Roboy/kicad_db/_3Dmodels/README.md

## this folder must be maintained empty on github
### the DIR structure is useful to test and generate models locally.
