Roboy/kicad_db/_3Dmodels/4UCON_17809/4UCON_17809_02x10x1.27mm_Vertical.step

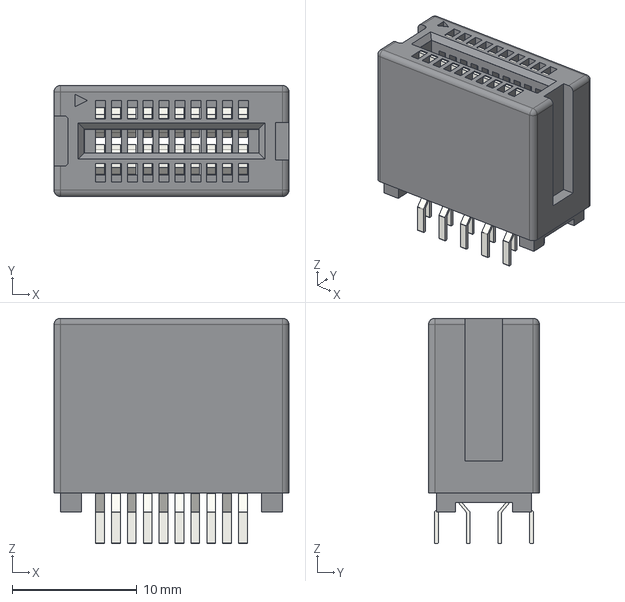
[picture p1: CAD file, 2017-06-21]
_3Dmodels/4UCON_17809/4UCON_17809_02x10x1.27mm_Vertical.step
18.8 x 8.88 x 18.0 mm
