Roboy/kicad_db/_3Dmodels/BGA_packages/Texas_Junior_DSBGA-12_4x3_2.5x2.0mm_Pitch0.5mm_Dia0.30mm.step

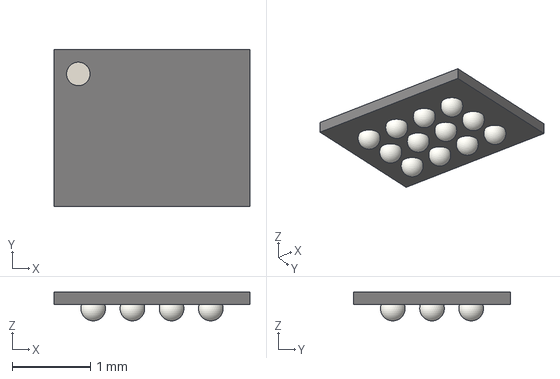
[picture p2: CAD file, 2017-06-21]
_3Dmodels/BGA_packages/Texas_Junior_DSBGA-12_4x3_2.5x2.0mm_Pitch0.5mm_Dia0.30mm.step
2.50 x 2.00 x 0.367 mm
