Roboy/kicad_db/_3Dmodels/Capacitors_Radial_SMD/CP_Elec_5x4.5.step

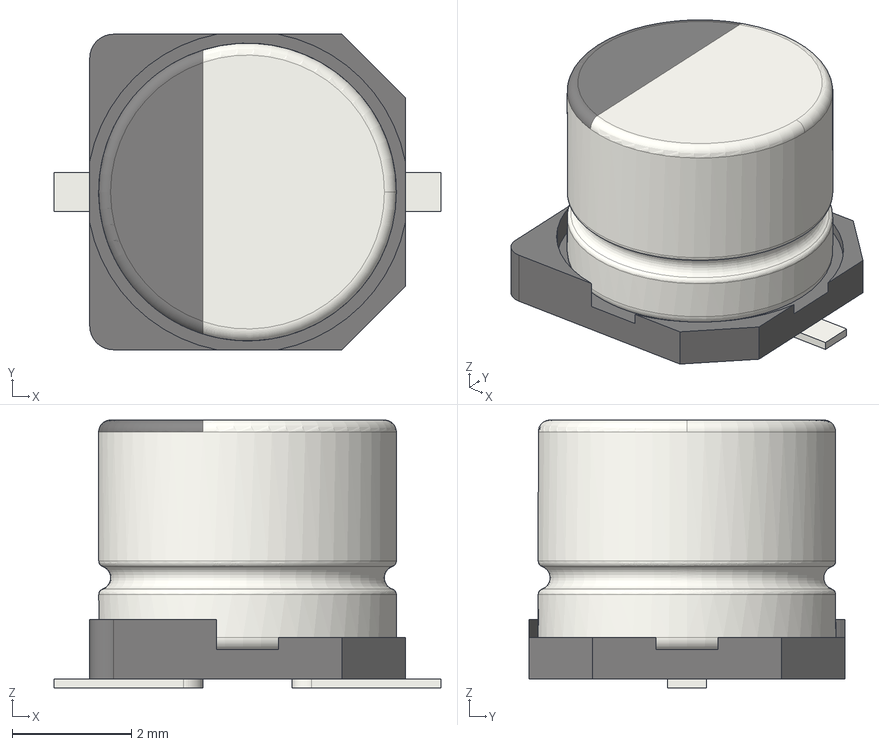
[picture p4: CAD file, 2017-06-21]
_3Dmodels/Capacitors_Radial_SMD/CP_Elec_5x4.5.step
6.50 x 5.30 x 4.50 mm
