Roboy/kicad_db/_3Dmodels/Capacitors_Radial_THT/CP_Radial_D10.0mm_P7.50mm.step

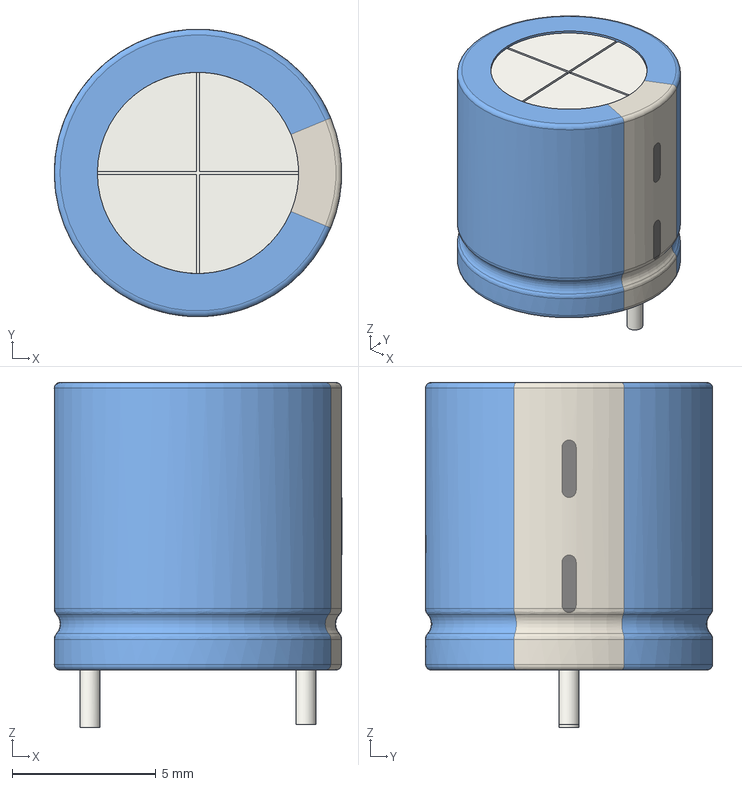
[picture p5: CAD file, 2017-06-21]
_3Dmodels/Capacitors_Radial_THT/CP_Radial_D10.0mm_P7.50mm.step
10.00 x 9.99 x 12.0 mm
