Roboy/kicad_db/_3Dmodels/Capacitors_Rect_THT/C_Rect_L4.6mm_W5.5mm_P2.50mm_MKS02_FKP02.step

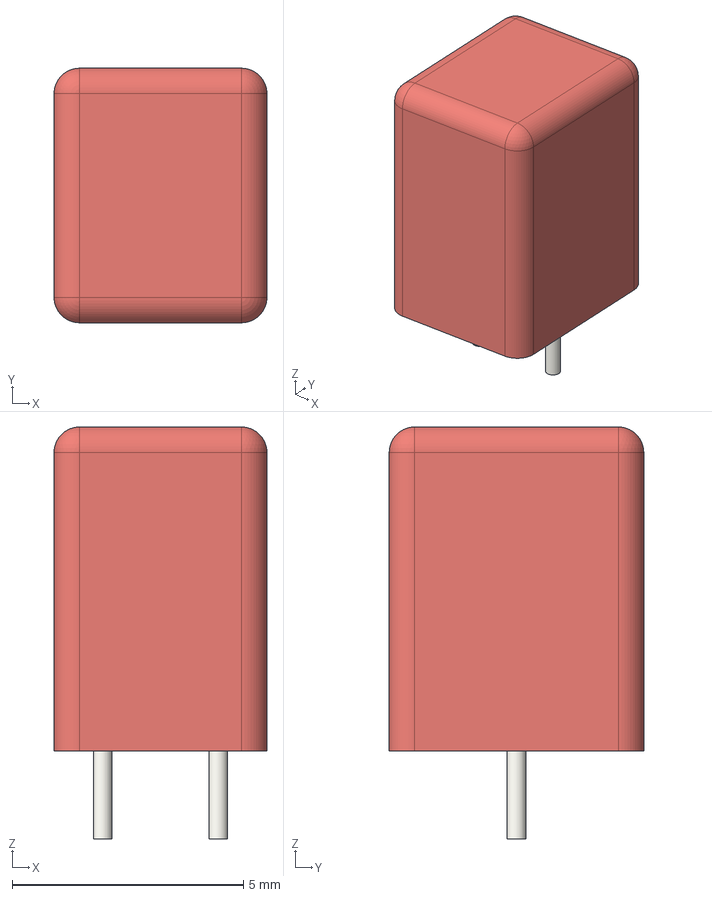
[picture p6: CAD file, 2017-06-21]
_3Dmodels/Capacitors_Rect_THT/C_Rect_L4.6mm_W5.5mm_P2.50mm_MKS02_FKP02.step
4.60 x 5.50 x 8.90 mm
