Roboy/kicad_db/_3Dmodels/custom_lib.3d_shapes/LED_WS2812B-PLCC4_3.5x3.5.step

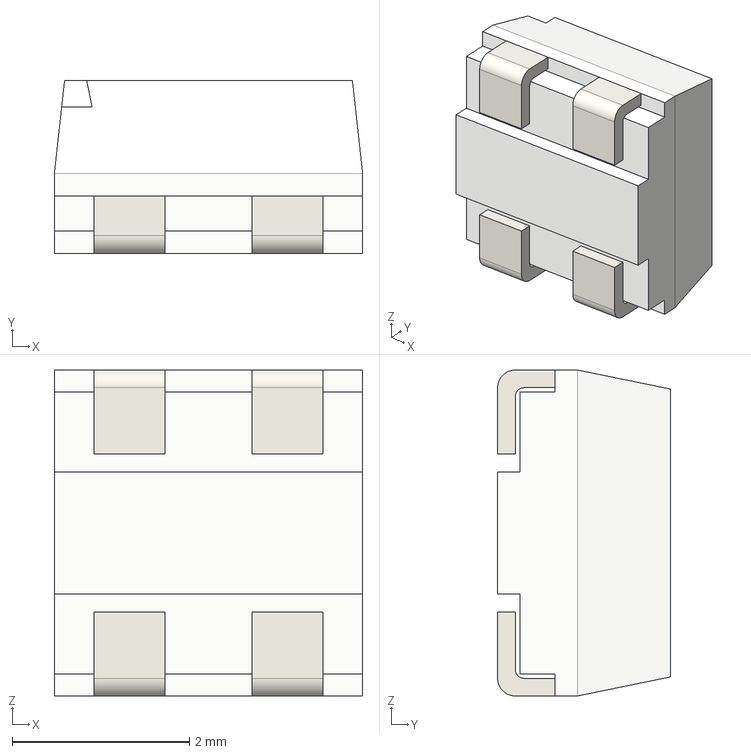
[picture p7: CAD file, 2019-05-12]
_3Dmodels/custom_lib.3d_shapes/LED_WS2812B-PLCC4_3.5x3.5.step
3.48 x 1.95 x 3.68 mm
