Roboy/kicad_db/_3Dmodels/Diodes_SMD/D_SMA.step

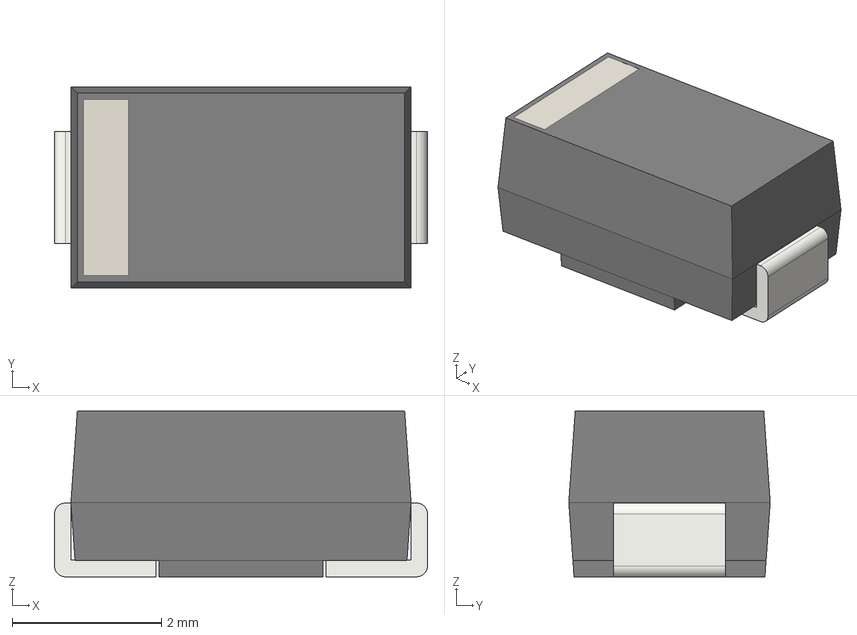
[picture p8: CAD file, 2017-06-21]
_3Dmodels/Diodes_SMD/D_SMA.step
5.00 x 2.70 x 2.22 mm
