Roboy/kicad_db/_3Dmodels/DIP_packages/DIP-48_W15.24mm.step

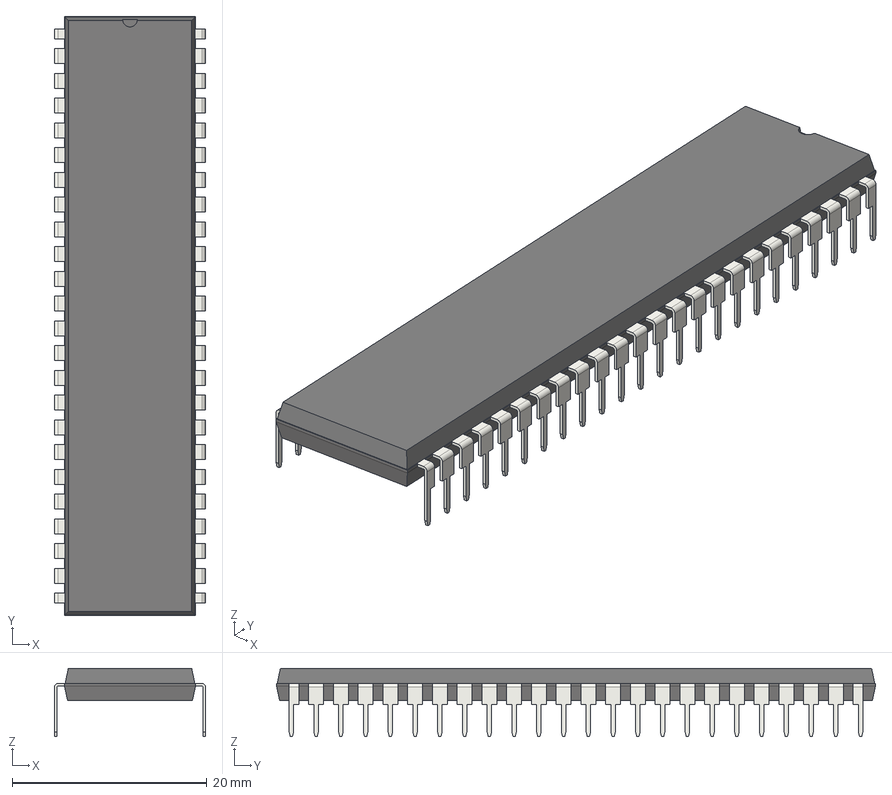
[picture p9: CAD file, 2017-06-21]
_3Dmodels/DIP_packages/DIP-48_W15.24mm.step
15.5 x 61.5 x 6.98 mm
