Roboy/kicad_db/_3Dmodels/TLE493d.step

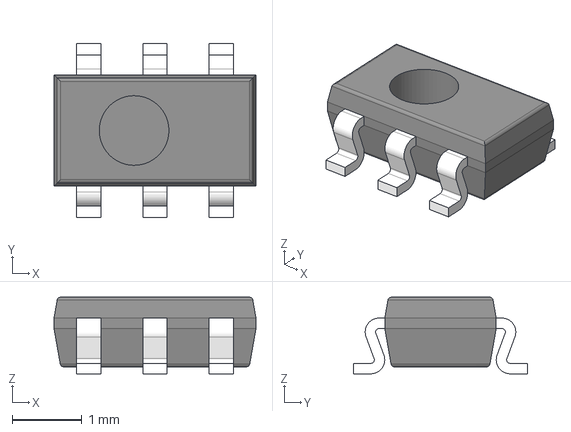
[picture p12: CAD file, 2020-06-25]
_3Dmodels/TLE493d.step
2.90 x 2.50 x 1.10 mm
