Roboy/kicad_db/_3Dmodels/4UCON_17809/4UCON_17809_02x40x1.27mm_Vertical.FCStd

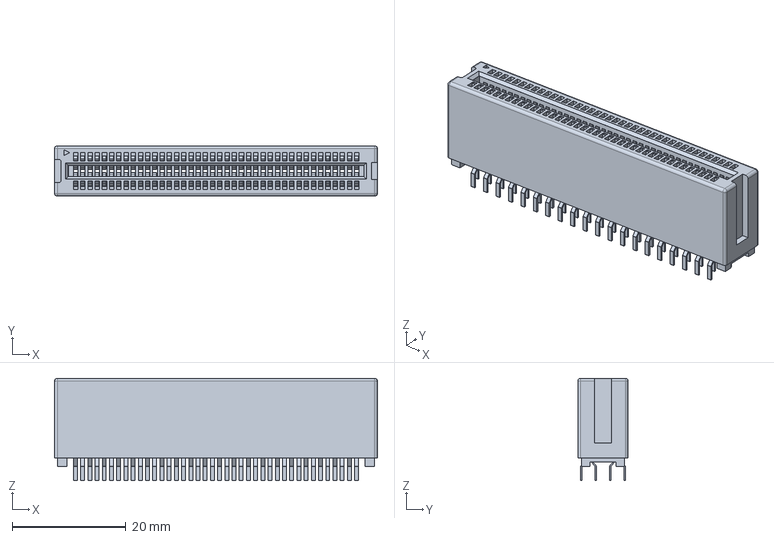
[picture p13: CAD file, 2017-06-21]
_3Dmodels/4UCON_17809/4UCON_17809_02x40x1.27mm_Vertical.FCStd
56.9 x 8.88 x 18.0 mm
