Roboy/kicad_db/_3Dmodels/BGA_packages/BGA-144_12x12_13.0x13.0mm_Pitch1.0mm.step

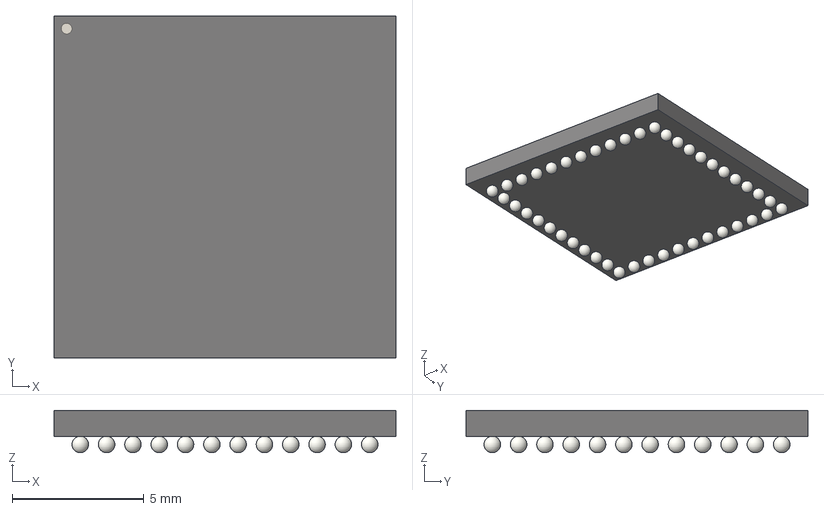
[picture p14: CAD file, 2017-06-21]
_3Dmodels/BGA_packages/BGA-144_12x12_13.0x13.0mm_Pitch1.0mm.step
13.0 x 13.0 x 1.61 mm
