Roboy/kicad_db/_3Dmodels/Box_Headers/Box_Header_Straight_2x20x2.54mm.step

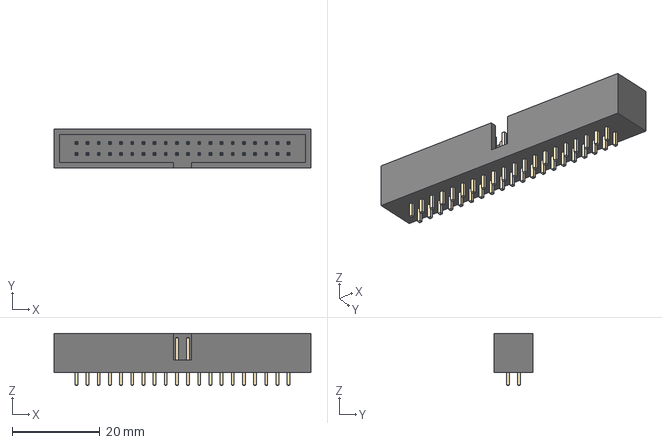
[picture p15: CAD file, 2017-06-21]
_3Dmodels/Box_Headers/Box_Header_Straight_2x20x2.54mm.step
58.4 x 8.90 x 11.9 mm
