Roboy/kicad_db/_3Dmodels/Capacitors_Radial_SMD/CP_Elec_8x6.5.step

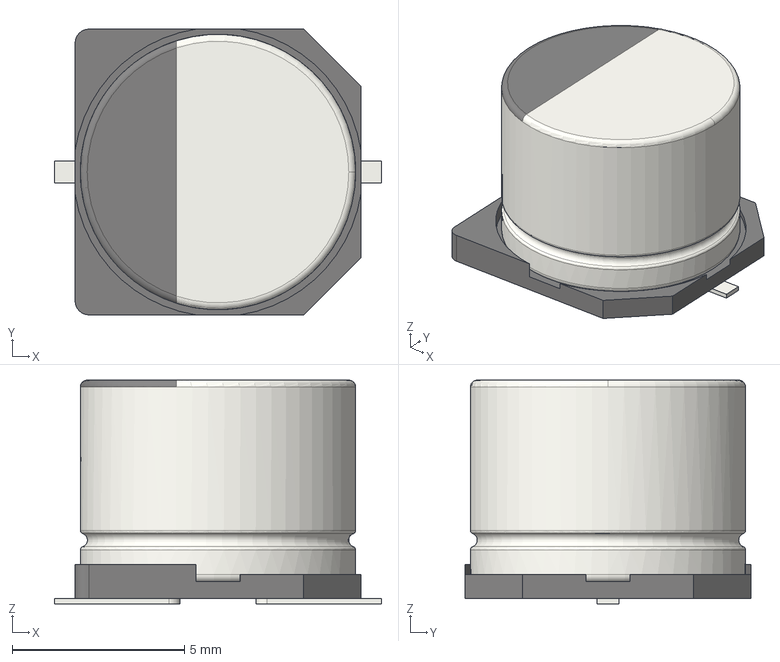
[picture p16: CAD file, 2017-06-21]
_3Dmodels/Capacitors_Radial_SMD/CP_Elec_8x6.5.step
9.50 x 8.30 x 6.50 mm
