Roboy/kicad_db/_3Dmodels/Capacitors_Radial_THT/CP_Radial_D8.0mm_P5.00mm.step

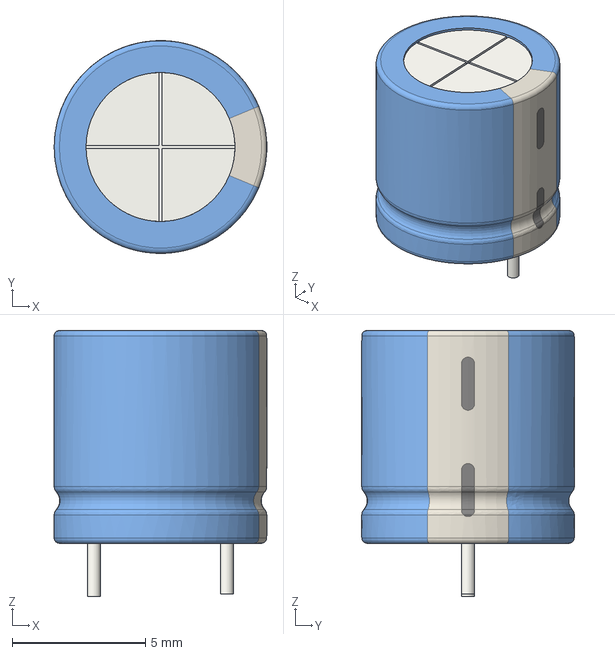
[picture p17: CAD file, 2017-06-21]
_3Dmodels/Capacitors_Radial_THT/CP_Radial_D8.0mm_P5.00mm.step
8.00 x 8.00 x 10.0 mm
