Roboy/kicad_db/_3Dmodels/Capacitors_Rect_THT/C_Rect_L16.5mm_W4.9mm_P15.00mm_MKT.step

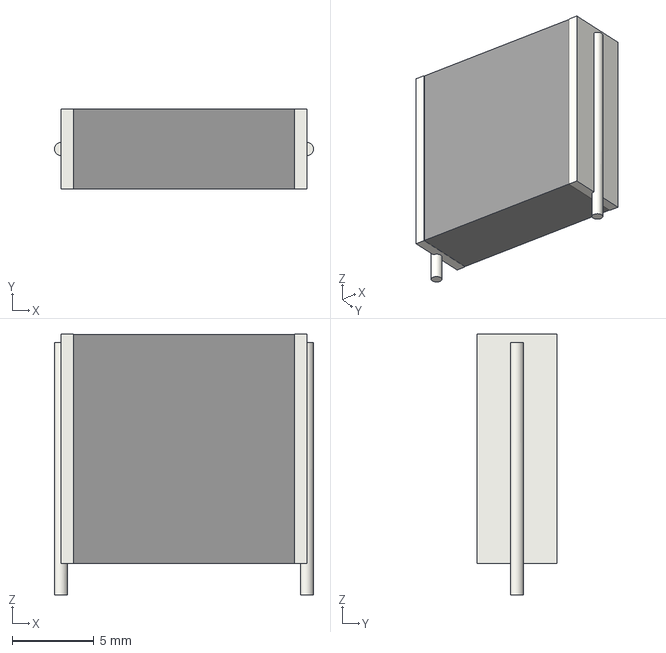
[picture p18: CAD file, 2017-06-21]
_3Dmodels/Capacitors_Rect_THT/C_Rect_L16.5mm_W4.9mm_P15.00mm_MKT.step
15.8 x 4.90 x 15.9 mm
