Roboy/kicad_db/_3Dmodels/Diodes_SMD/D_SMC.step

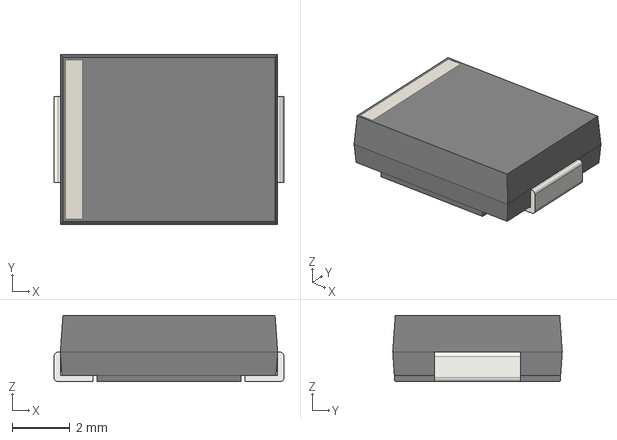
[picture p19: CAD file, 2017-06-21]
_3Dmodels/Diodes_SMD/D_SMC.step
8.00 x 5.90 x 2.31 mm
