Roboy/kicad_db/_3Dmodels/DIP_packages/DIP-24_W10.16mm.step

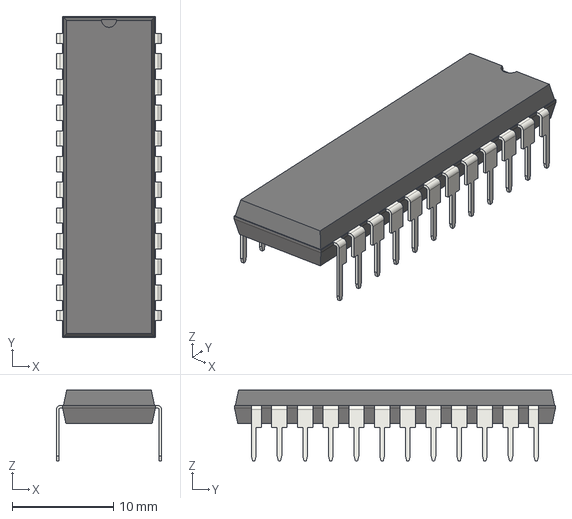
[picture p20: CAD file, 2017-06-21]
_3Dmodels/DIP_packages/DIP-24_W10.16mm.step
10.4 x 31.8 x 6.98 mm
