Roboy/kicad_db/_3Dmodels/GullWings_packages/QFP/LQFP-44_10x10mm_Pitch0.8mm.step

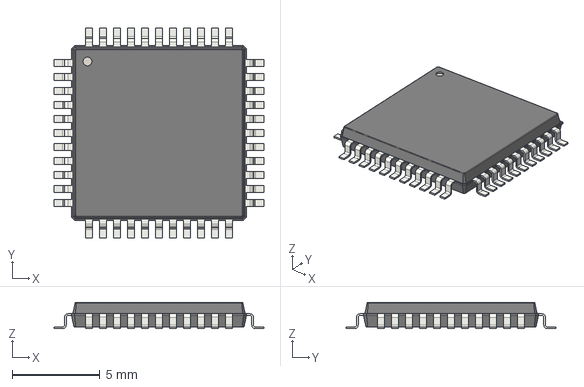
[picture p21: CAD file, 2017-06-21]
_3Dmodels/GullWings_packages/QFP/LQFP-44_10x10mm_Pitch0.8mm.step
12.0 x 12.0 x 1.50 mm
