Roboy/kicad_db/_3Dmodels/GullWings_packages/SOIC/SO-6L_10x3.84mm_Pitch1.27mm.step

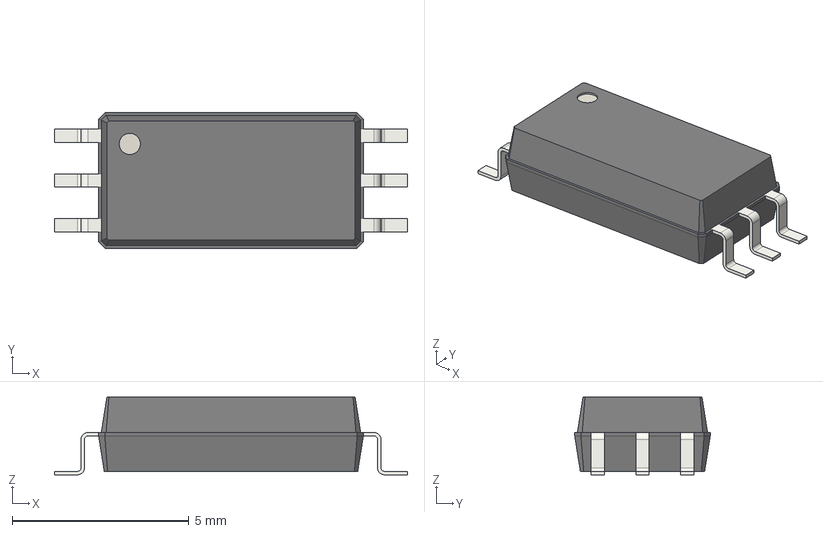
[picture p22: CAD file, 2017-06-21]
_3Dmodels/GullWings_packages/SOIC/SO-6L_10x3.84mm_Pitch1.27mm.step
10.0 x 3.84 x 2.20 mm
