Roboy/kicad_db/_3Dmodels/PTS810SJG250SMTRLFS.stp

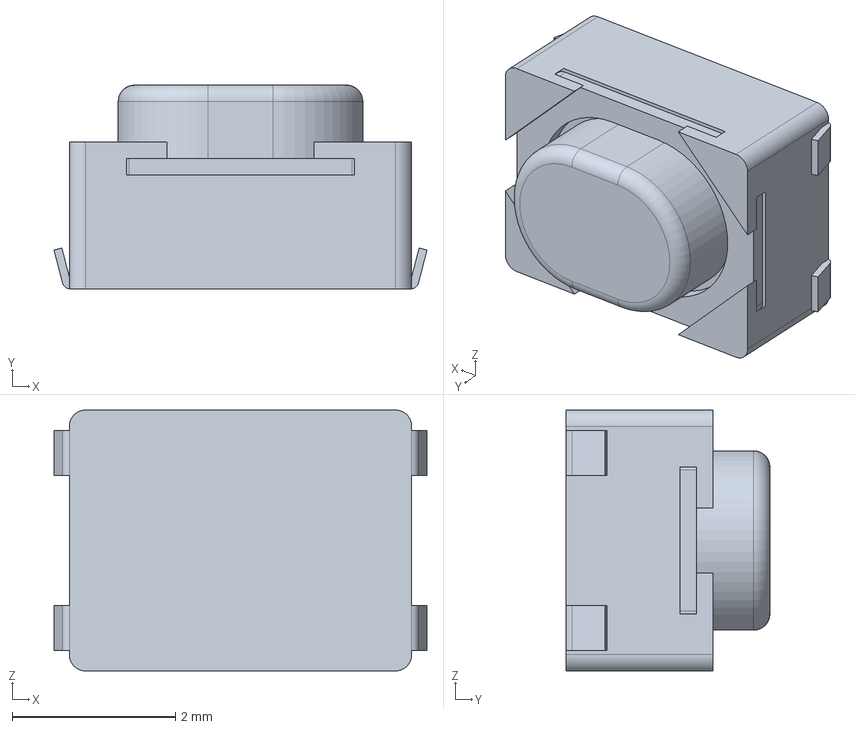
[picture p23: CAD file, 2020-06-25]
_3Dmodels/PTS810SJG250SMTRLFS.stp
4.58 x 2.50 x 3.20 mm
