Roboy/kicad_db/_3Dmodels/BGA_packages/BGA-1156_34x34_35.0x35.0mm_Pitch1.0mm.step

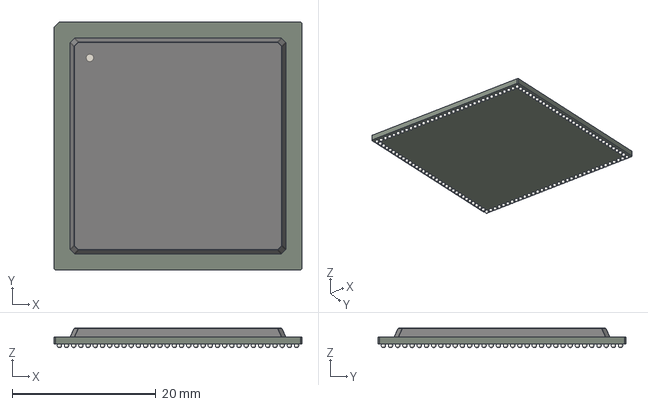
[picture p24: CAD file, 2017-06-21]
_3Dmodels/BGA_packages/BGA-1156_34x34_35.0x35.0mm_Pitch1.0mm.step
34.5 x 34.5 x 2.72 mm
