Roboy/kicad_db/_3Dmodels/Capacitors_Radial_SMD/CP_Elec_5x5.8.step

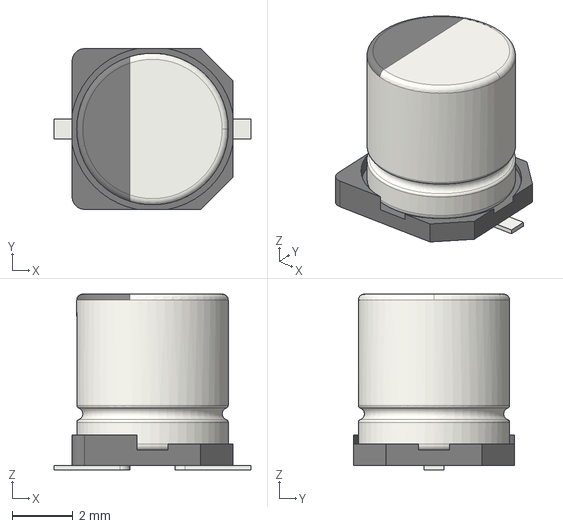
[picture p26: CAD file, 2017-06-21]
_3Dmodels/Capacitors_Radial_SMD/CP_Elec_5x5.8.step
6.50 x 5.30 x 5.80 mm
