Roboy/kicad_db/_3Dmodels/Capacitors_Rect_THT/C_Rect_L11.5mm_W6.4mm_P10.00mm_MKT.step

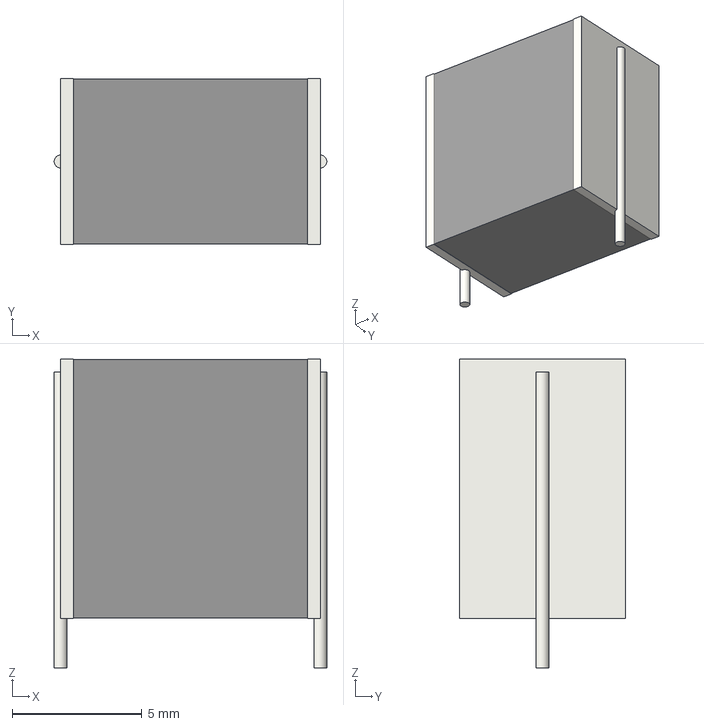
[picture p27: CAD file, 2017-06-21]
_3Dmodels/Capacitors_Rect_THT/C_Rect_L11.5mm_W6.4mm_P10.00mm_MKT.step
10.5 x 6.40 x 11.9 mm
