Roboy/kicad_db/_3Dmodels/Diodes_SMD/D_SMB.step

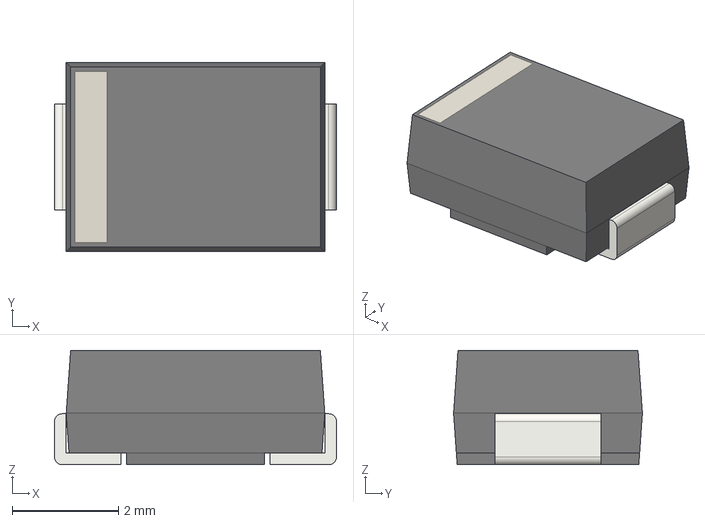
[picture p28: CAD file, 2017-06-21]
_3Dmodels/Diodes_SMD/D_SMB.step
5.30 x 3.55 x 2.15 mm
