Roboy/kicad_db/_3Dmodels/DIP_packages/DIP-64_W22.86mm.step

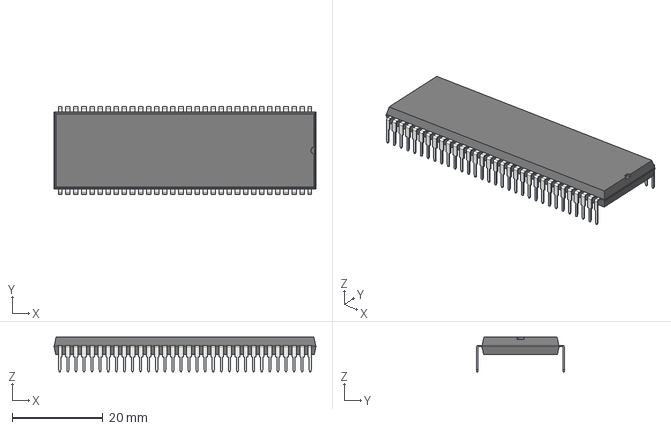
[picture p29: CAD file, 2017-06-21]
_3Dmodels/DIP_packages/DIP-64_W22.86mm.step
57.7 x 19.3 x 7.62 mm
