Roboy/kicad_db/_3Dmodels/vishay_tcut1350x01.stp

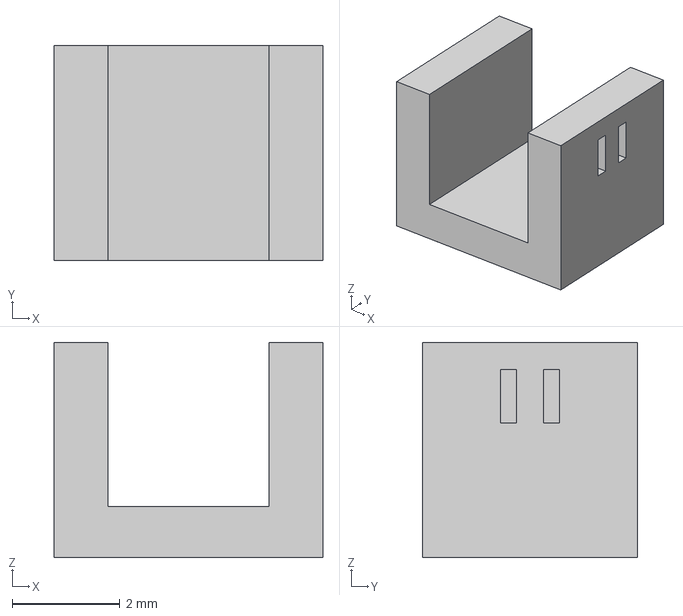
[picture p32: CAD file, 2019-12-09]
_3Dmodels/vishay_tcut1350x01.stp
5.00 x 4.00 x 4.00 mm
