Roboy/kicad_db/_3Dmodels/BGA_packages/BGA-484_22x22_23.0x23.0mm_Pitch1.0mm.step

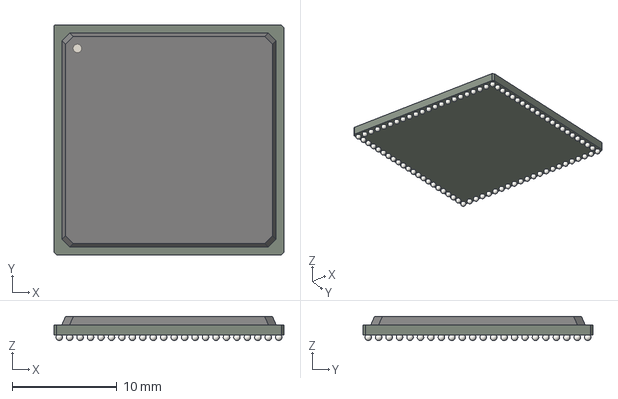
[picture p33: CAD file, 2017-06-21]
_3Dmodels/BGA_packages/BGA-484_22x22_23.0x23.0mm_Pitch1.0mm.step
22.0 x 22.0 x 2.31 mm
