Roboy/kicad_db/_3Dmodels/Capacitors_Radial_SMD/CP_Elec_8x10.5.step

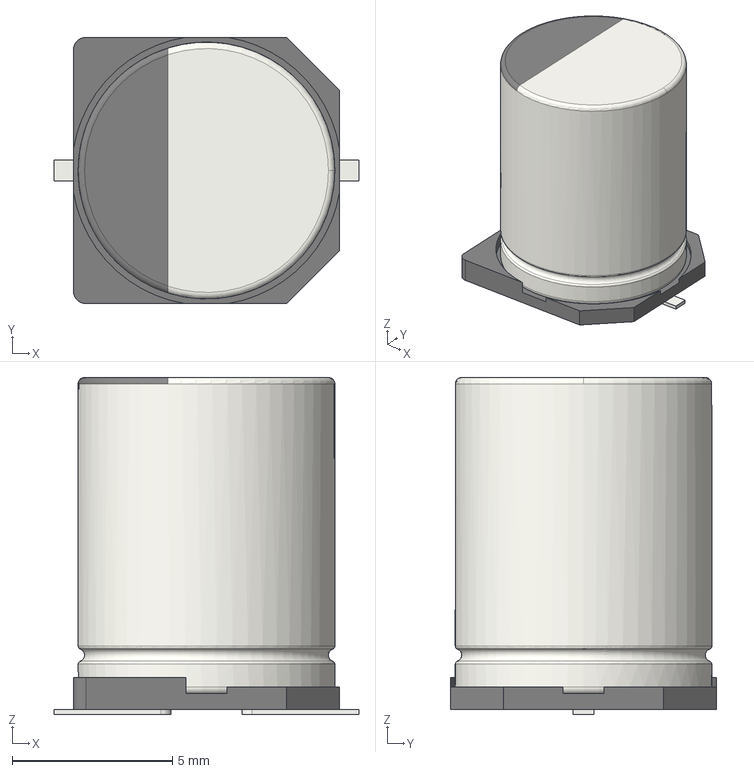
[picture p35: CAD file, 2017-06-21]
_3Dmodels/Capacitors_Radial_SMD/CP_Elec_8x10.5.step
9.50 x 8.30 x 10.5 mm
