Roboy/kicad_db/_3Dmodels/Capacitors_Rect_THT/C_Rect_L26.5mm_W8.5mm_P22.50mm_MKS4.step

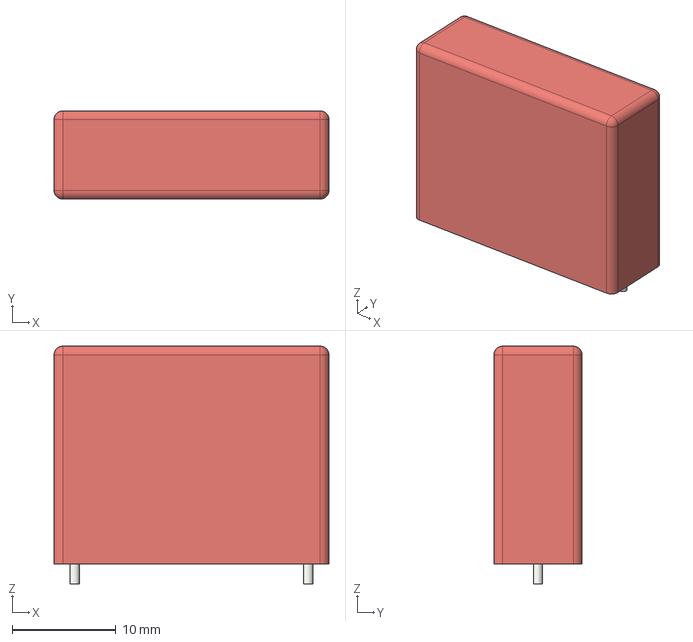
[picture p37: CAD file, 2017-06-21]
_3Dmodels/Capacitors_Rect_THT/C_Rect_L26.5mm_W8.5mm_P22.50mm_MKS4.step
26.5 x 8.50 x 22.9 mm
