Roboy/kicad_db/_3Dmodels/DIP_packages/DIP-4_W7.62mm.step

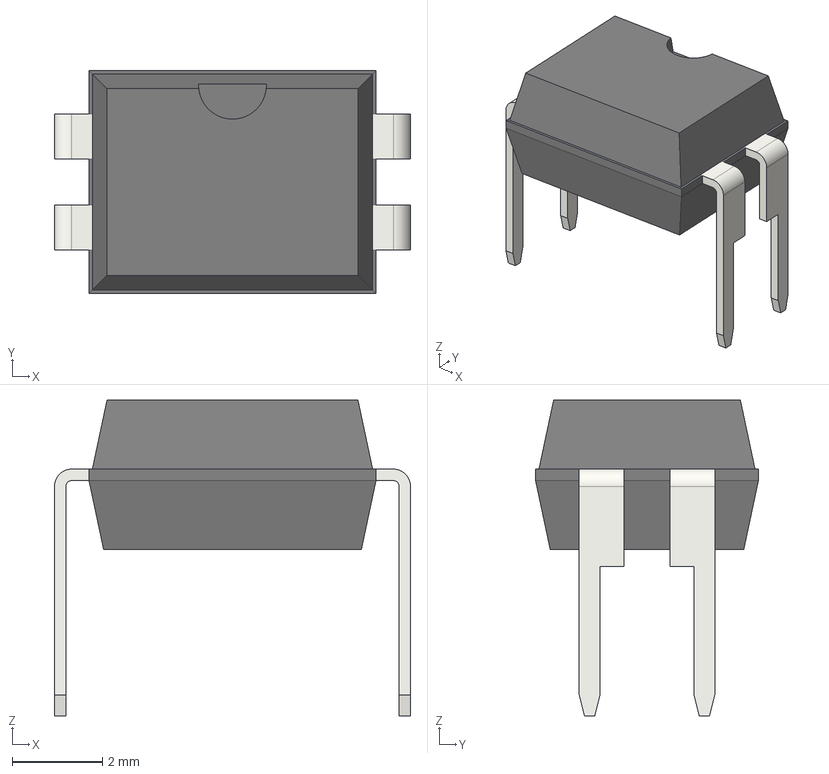
[picture p38: CAD file, 2017-06-21]
_3Dmodels/DIP_packages/DIP-4_W7.62mm.step
7.87 x 4.93 x 6.98 mm
