Roboy/kicad_db/_3Dmodels/ESP-WROOM-02D--3DModel-STEP-56544.STEP

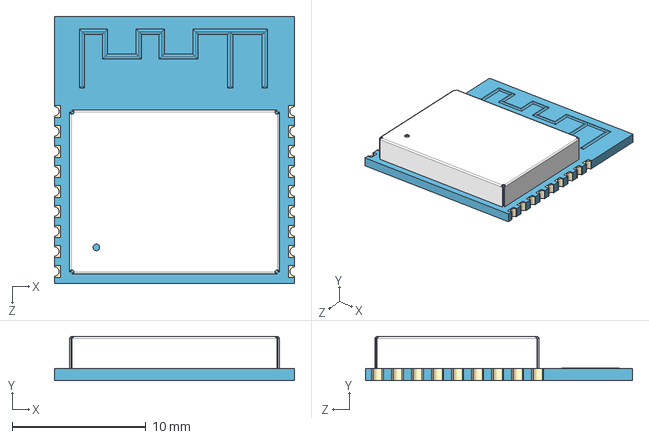
[picture p39: CAD file, 2019-12-09]
_3Dmodels/ESP-WROOM-02D--3DModel-STEP-56544.STEP
18.0 x 3.30 x 20.0 mm
