Roboy/kicad_db/_3Dmodels/GullWings_packages/SOIC/SOIC-16_3.9x9.9mm_Pitch1.27mm.step

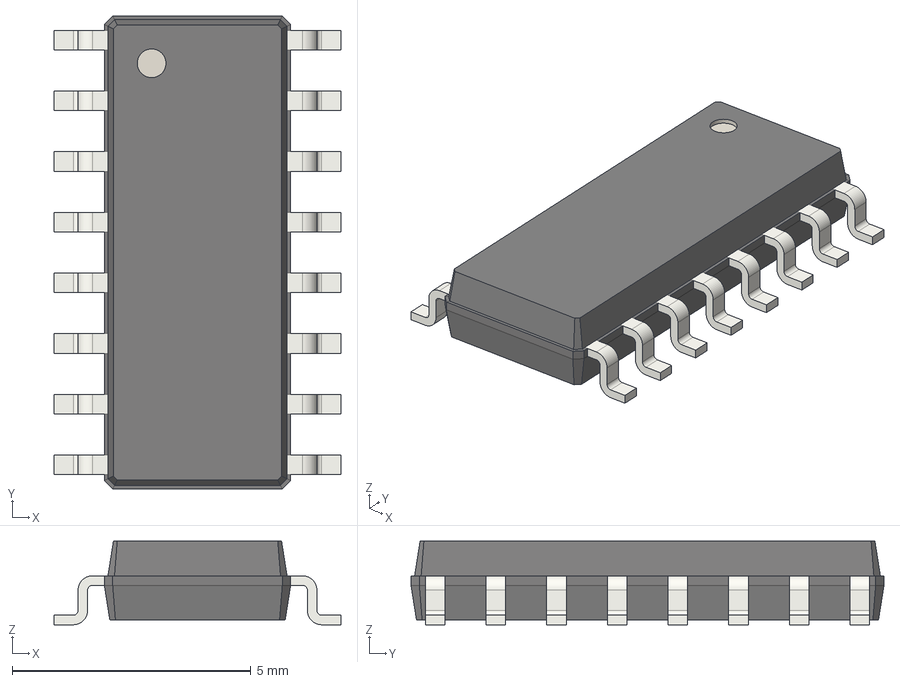
[picture p41: CAD file, 2017-06-21]
_3Dmodels/GullWings_packages/SOIC/SOIC-16_3.9x9.9mm_Pitch1.27mm.step
6.00 x 9.90 x 1.75 mm
