Roboy/kicad_db/_3Dmodels/BGA_packages/BGA-48_6x8_8.0x9.0mm_Pitch0.8mm.step

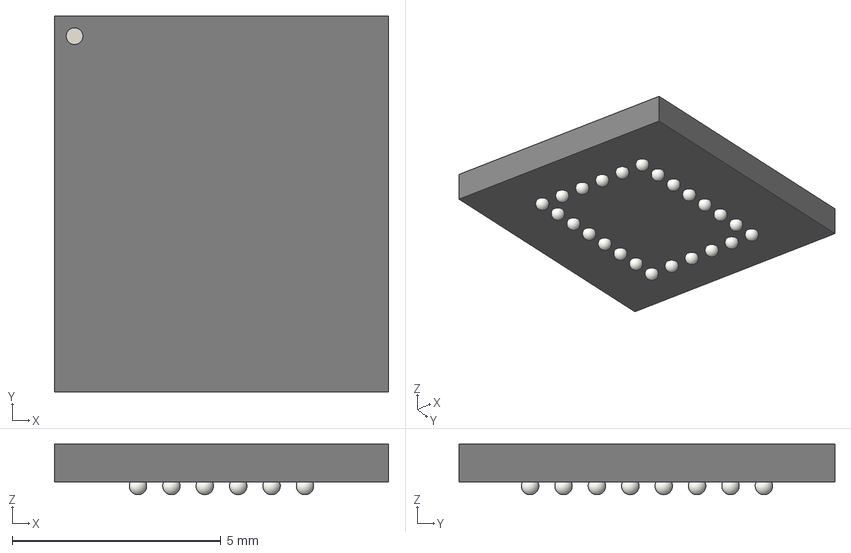
[picture p42: CAD file, 2017-06-21]
_3Dmodels/BGA_packages/BGA-48_6x8_8.0x9.0mm_Pitch0.8mm.step
8.00 x 9.00 x 1.21 mm
