Roboy/kicad_db/_3Dmodels/Capacitors_Radial_THT/CP_Radial_D25.0mm_P10.00mm_3pin_SnapIn.step

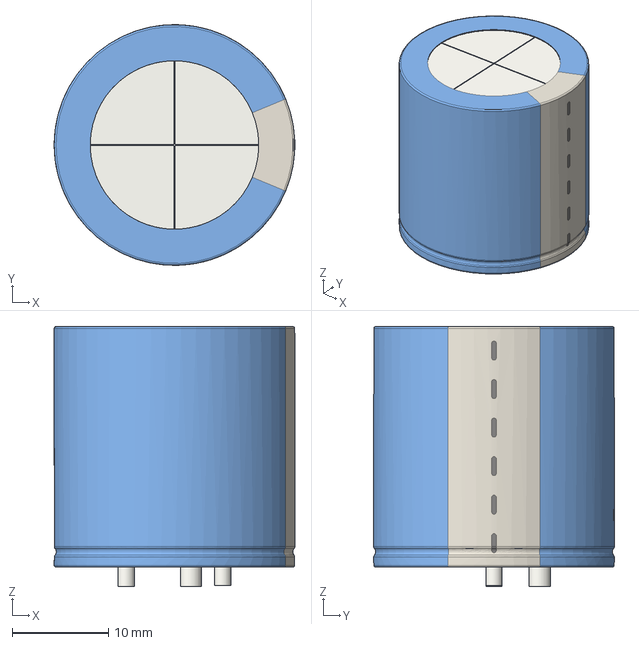
[picture p45: CAD file, 2017-06-21]
_3Dmodels/Capacitors_Radial_THT/CP_Radial_D25.0mm_P10.00mm_3pin_SnapIn.step
25.0 x 25.0 x 27.0 mm
