Roboy/kicad_db/_3Dmodels/GullWings_packages/SOIC/SOIC-24W_7.5x15.4mm_Pitch1.27mm.step

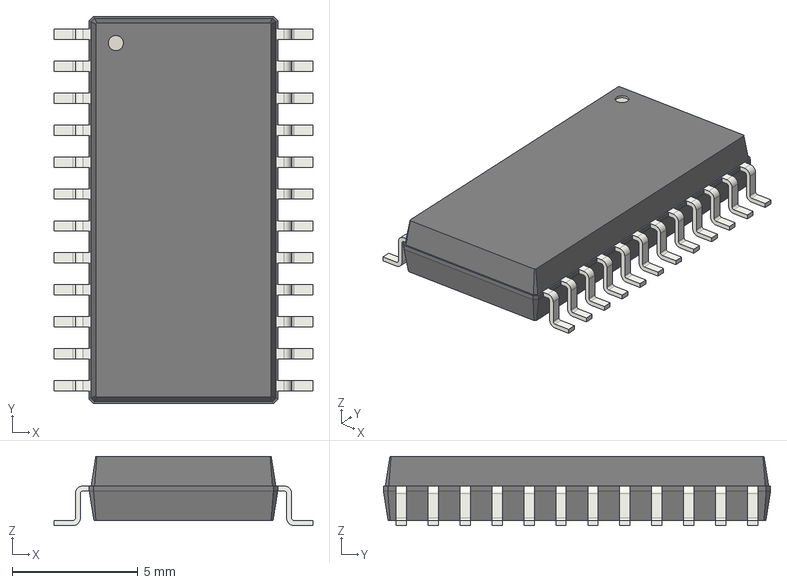
[picture p49: CAD file, 2017-06-21]
_3Dmodels/GullWings_packages/SOIC/SOIC-24W_7.5x15.4mm_Pitch1.27mm.step
10.3 x 15.4 x 2.75 mm
