Roboy/kicad_db/_3Dmodels/Capacitors_Radial_THT/CP_Radial_D22.0mm_P10.00mm_SnapIn.step

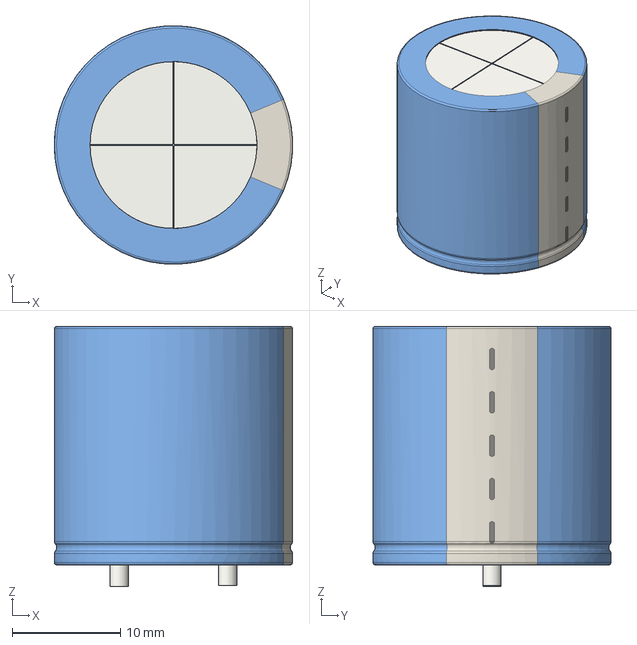
[picture p53: CAD file, 2017-06-21]
_3Dmodels/Capacitors_Radial_THT/CP_Radial_D22.0mm_P10.00mm_SnapIn.step
22.0 x 22.0 x 24.0 mm
