Roboy/kicad_db/_3Dmodels/Capacitors_Rect_THT/C_Rect_L9.0mm_W4.2mm_P7.50mm_MKT.step

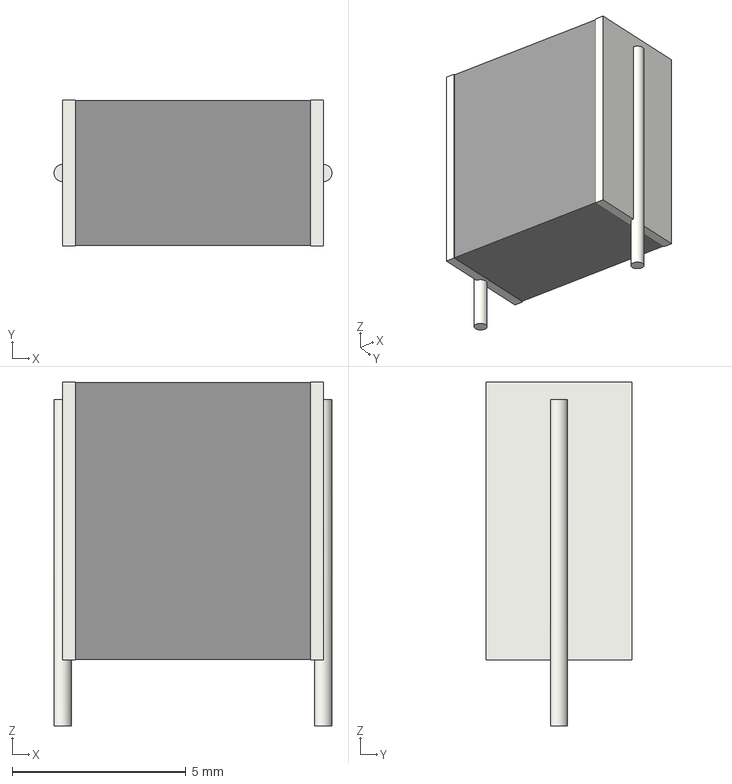
[picture p61: CAD file, 2017-06-21]
_3Dmodels/Capacitors_Rect_THT/C_Rect_L9.0mm_W4.2mm_P7.50mm_MKT.step
8.00 x 4.20 x 9.90 mm
