Roboy/kicad_db/_3Dmodels/DIP_packages/DIP-64_W15.24mm.step

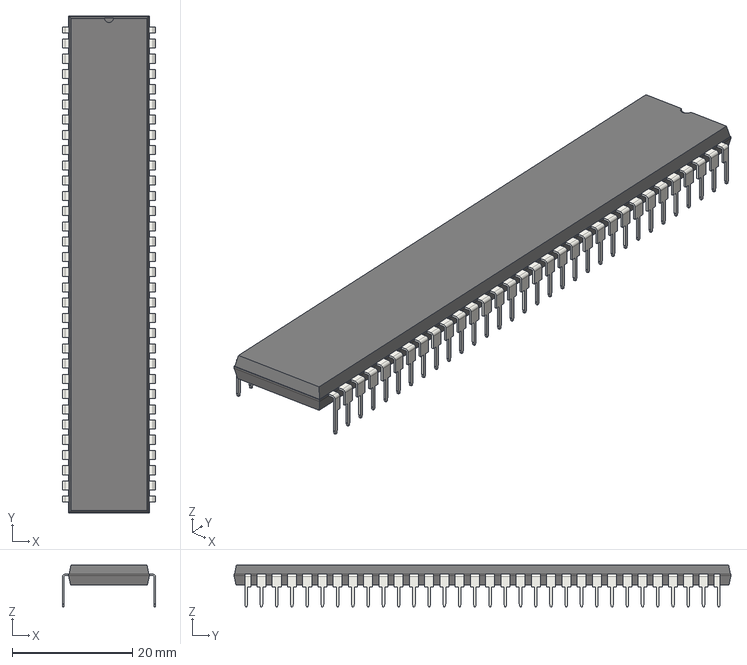
[picture p62: CAD file, 2017-06-21]
_3Dmodels/DIP_packages/DIP-64_W15.24mm.step
15.5 x 82.8 x 6.98 mm
