Roboy/kicad_db/_3Dmodels/GullWings_packages/SOIC/SOIC-28W_7.5x17.9mm_Pitch1.27mm.step

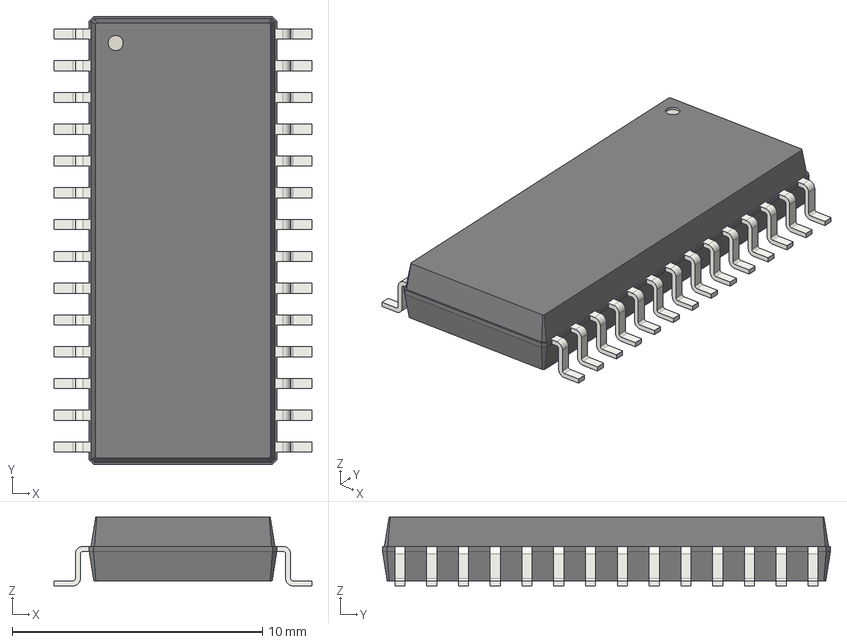
[picture p64: CAD file, 2017-06-21]
_3Dmodels/GullWings_packages/SOIC/SOIC-28W_7.5x17.9mm_Pitch1.27mm.step
10.3 x 17.9 x 2.75 mm
