Roboy/kicad_db/_3Dmodels/BGA_packages/DSBGA-12_3x4_1.36x1.86mm_Pitch0.5mm_Dia0.25mm.step

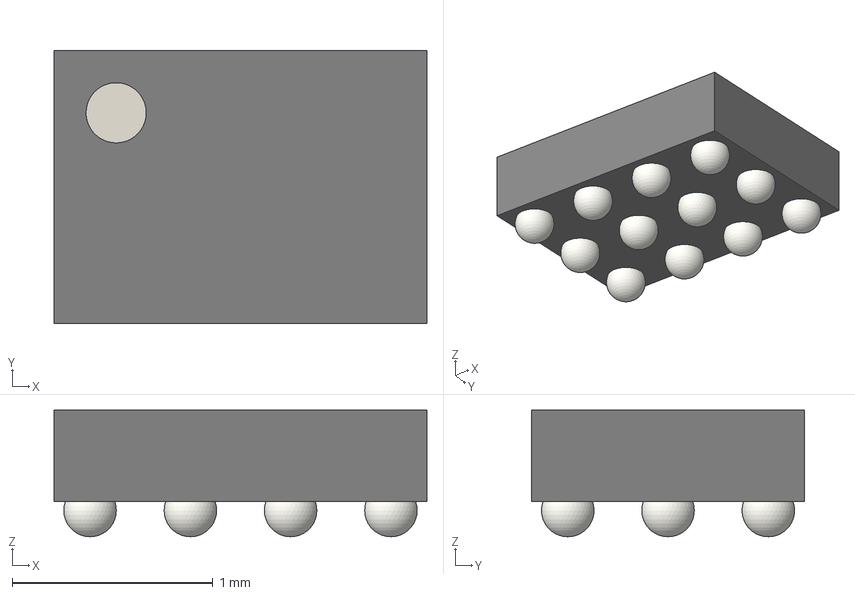
[picture p65: CAD file, 2017-06-21]
_3Dmodels/BGA_packages/DSBGA-12_3x4_1.36x1.86mm_Pitch0.5mm_Dia0.25mm.step
1.86 x 1.36 x 0.631 mm
