Roboy/kicad_db/_3Dmodels/Capacitors_Radial_THT/CP_Radial_D13.0mm_P5.00mm.step

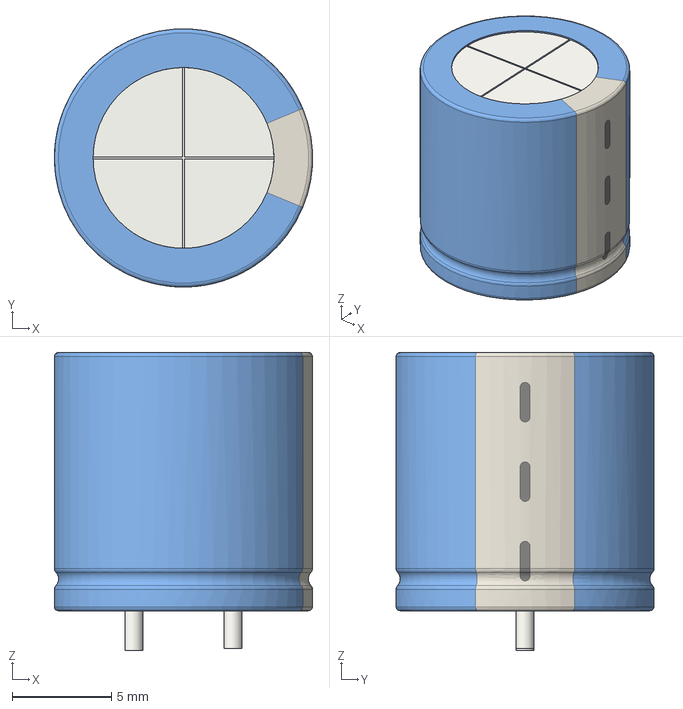
[picture p68: CAD file, 2017-06-21]
_3Dmodels/Capacitors_Radial_THT/CP_Radial_D13.0mm_P5.00mm.step
13.0 x 13.0 x 15.0 mm
