Roboy/kicad_db/_3Dmodels/Capacitors_Rect_THT/C_Rect_L19.0mm_W7.0mm_P15.00mm_MKS4.step

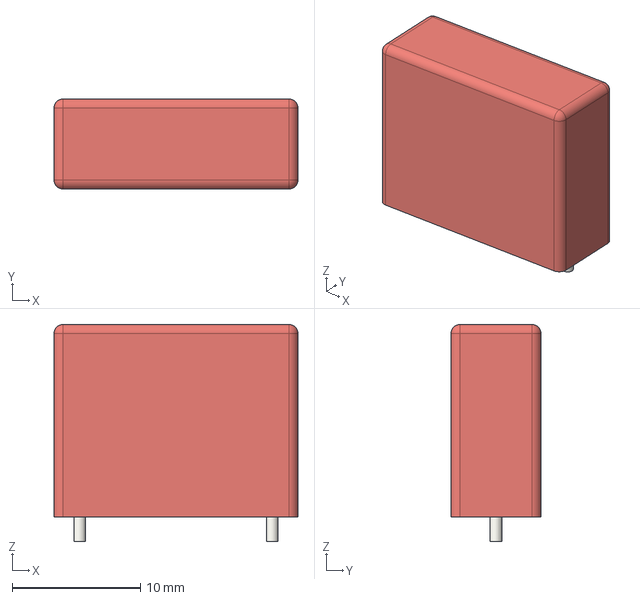
[picture p69: CAD file, 2017-06-21]
_3Dmodels/Capacitors_Rect_THT/C_Rect_L19.0mm_W7.0mm_P15.00mm_MKS4.step
19.0 x 7.00 x 16.9 mm
