Roboy/kicad_db/_3Dmodels/GullWings_packages/QFP/LQFP-208_28x28mm_Pitch0.5mm.FCStd

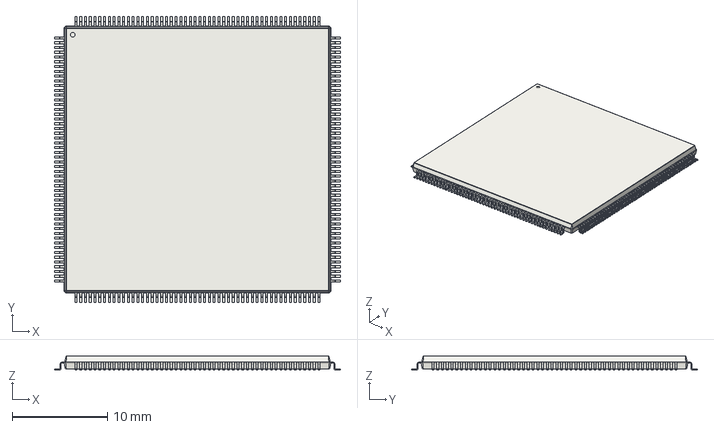
[picture p71: CAD file, 2017-06-21]
_3Dmodels/GullWings_packages/QFP/LQFP-208_28x28mm_Pitch0.5mm.FCStd
30.0 x 30.0 x 1.50 mm
