Roboy/kicad_db/_3Dmodels/GullWings_packages/SOIC/SOIC-14_3.9x8.7mm_Pitch1.27mm.step

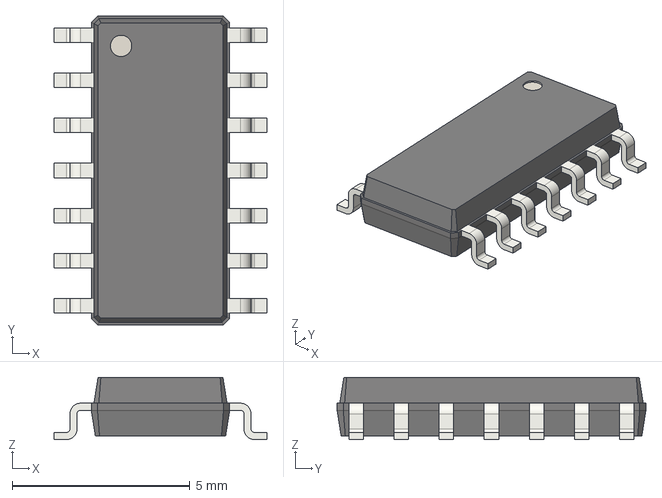
[picture p72: CAD file, 2017-06-21]
_3Dmodels/GullWings_packages/SOIC/SOIC-14_3.9x8.7mm_Pitch1.27mm.step
6.00 x 8.70 x 1.75 mm
