Roboy/kicad_db/_3Dmodels/BGA_packages/BGA-400_20x20_21.0x21.0mm_Pitch1.0mm.step

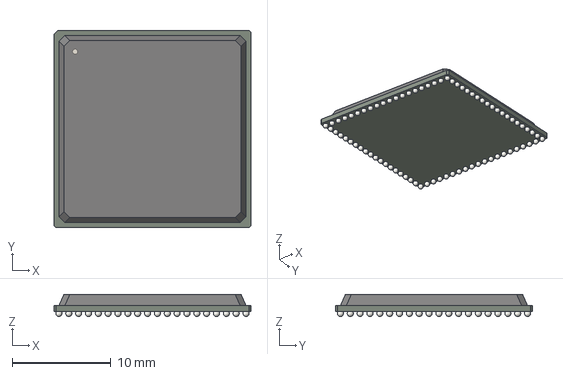
[picture p73: CAD file, 2017-06-21]
_3Dmodels/BGA_packages/BGA-400_20x20_21.0x21.0mm_Pitch1.0mm.step
20.0 x 20.0 x 2.25 mm
