Roboy/kicad_db/_3Dmodels/Capacitors_Rect_THT/C_Rect_L41.5mm_W17.0mm_P37.50mm_MKS4.step

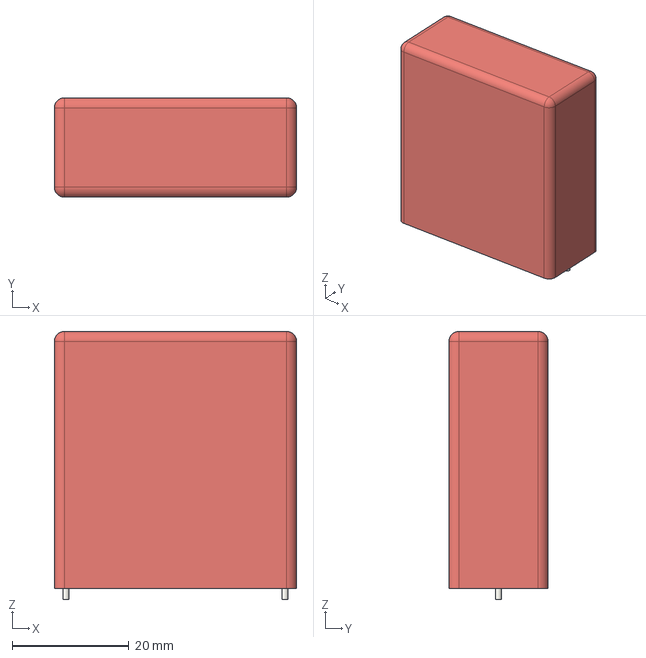
[picture p75: CAD file, 2017-06-21]
_3Dmodels/Capacitors_Rect_THT/C_Rect_L41.5mm_W17.0mm_P37.50mm_MKS4.step
41.5 x 17.0 x 45.9 mm
