Roboy/kicad_db/_3Dmodels/DIP_packages/DIP-24_W15.24mm.step

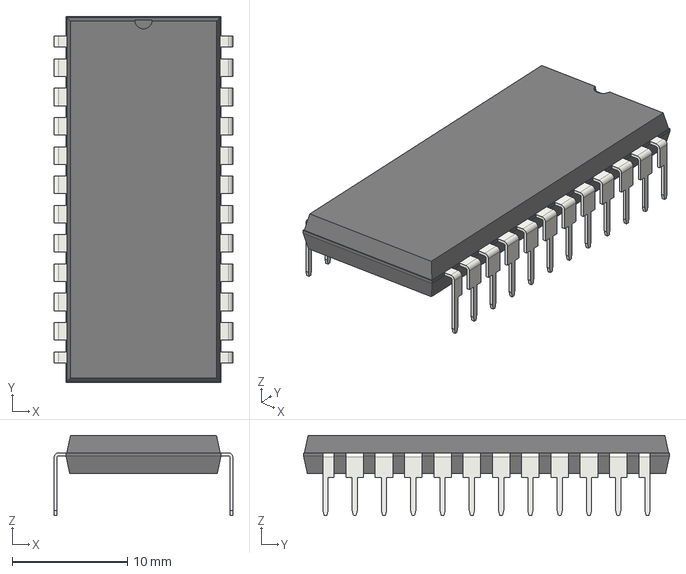
[picture p76: CAD file, 2017-06-21]
_3Dmodels/DIP_packages/DIP-24_W15.24mm.step
15.5 x 31.8 x 6.98 mm
