Roboy/kicad_db/_3Dmodels/GullWings_packages/QFP/TQFP-80_12x12mm_Pitch0.5mm.step

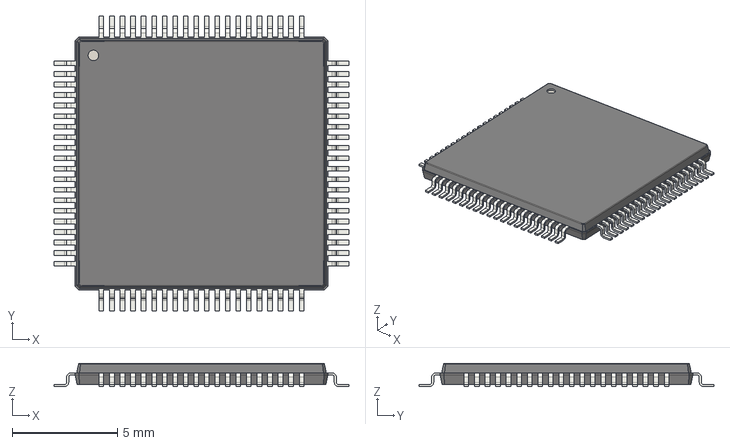
[picture p77: CAD file, 2017-06-21]
_3Dmodels/GullWings_packages/QFP/TQFP-80_12x12mm_Pitch0.5mm.step
14.0 x 14.0 x 1.10 mm
