Roboy/kicad_db/_3Dmodels/GullWings_packages/SOIC/SOIJ-8_5.3x5.3mm_Pitch1.27mm.step

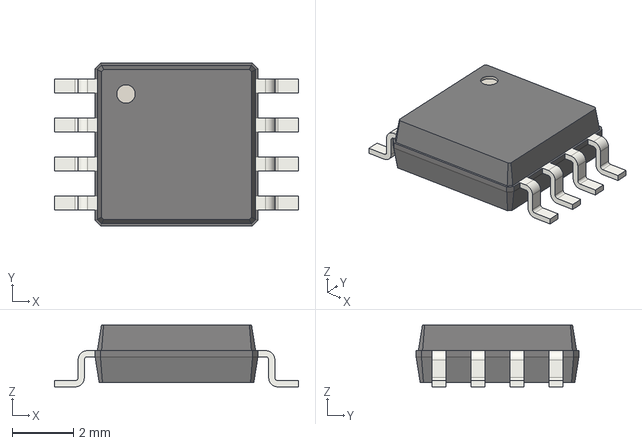
[picture p78: CAD file, 2017-06-21]
_3Dmodels/GullWings_packages/SOIC/SOIJ-8_5.3x5.3mm_Pitch1.27mm.step
7.94 x 5.30 x 2.01 mm
