Roboy/kicad_db/_3Dmodels/BGA_packages/BGA-100_10x10_9.0x9.0mm_Pitch0.8mm.step

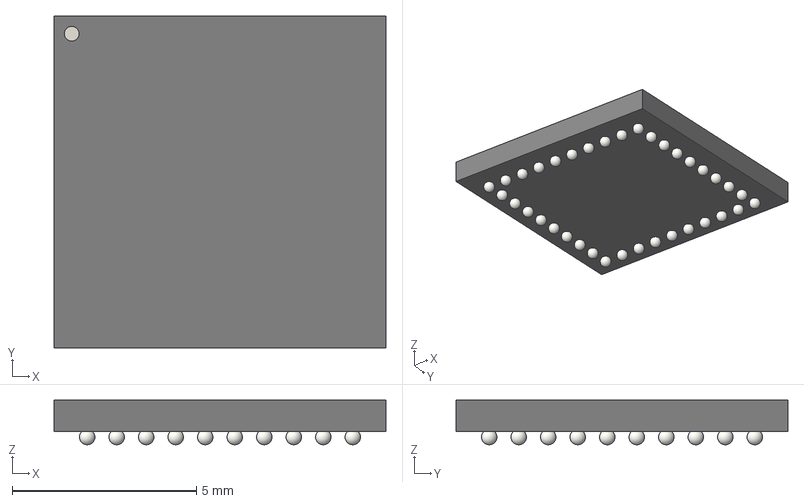
[picture p79: CAD file, 2017-06-21]
_3Dmodels/BGA_packages/BGA-100_10x10_9.0x9.0mm_Pitch0.8mm.step
9.00 x 9.00 x 1.21 mm
