Roboy/kicad_db/_3Dmodels/DIP_packages/DIP-6_W7.62mm.step

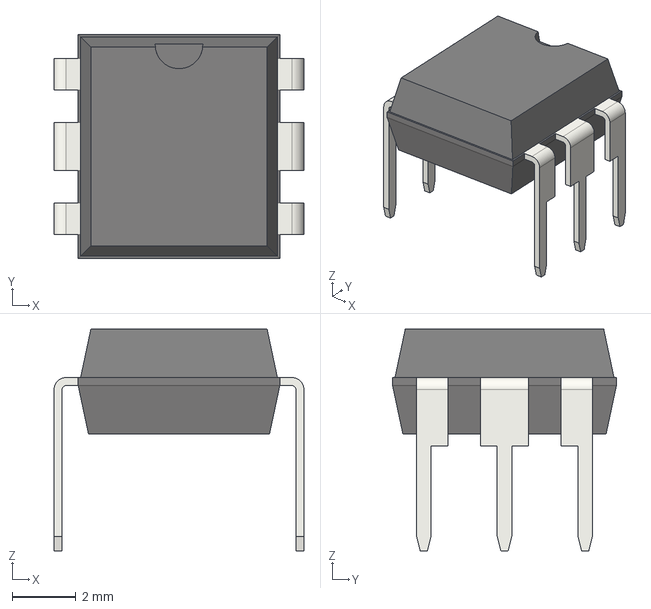
[picture p84: CAD file, 2017-06-21]
_3Dmodels/DIP_packages/DIP-6_W7.62mm.step
7.87 x 7.05 x 6.98 mm
