Roboy/kicad_db/_3Dmodels/GullWings_packages/QFP/TQFP-144_20x20mm_Pitch0.5mm.step

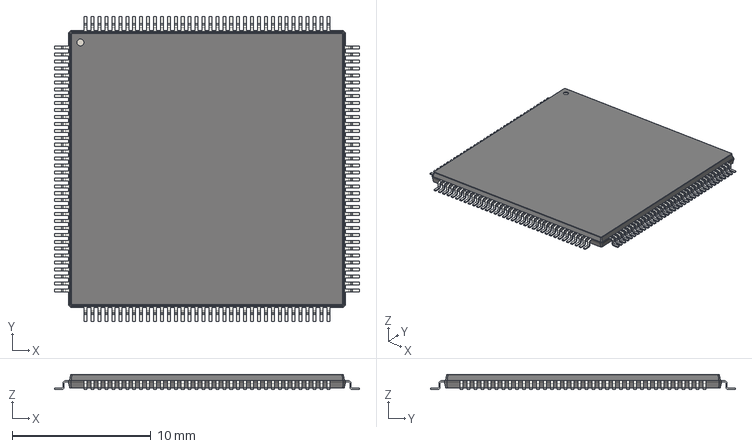
[picture p85: CAD file, 2017-06-21]
_3Dmodels/GullWings_packages/QFP/TQFP-144_20x20mm_Pitch0.5mm.step
22.0 x 22.0 x 1.10 mm
