Roboy/kicad_db/_3Dmodels/Capacitors_Radial_SMD/CP_Elec_5x5.3.step

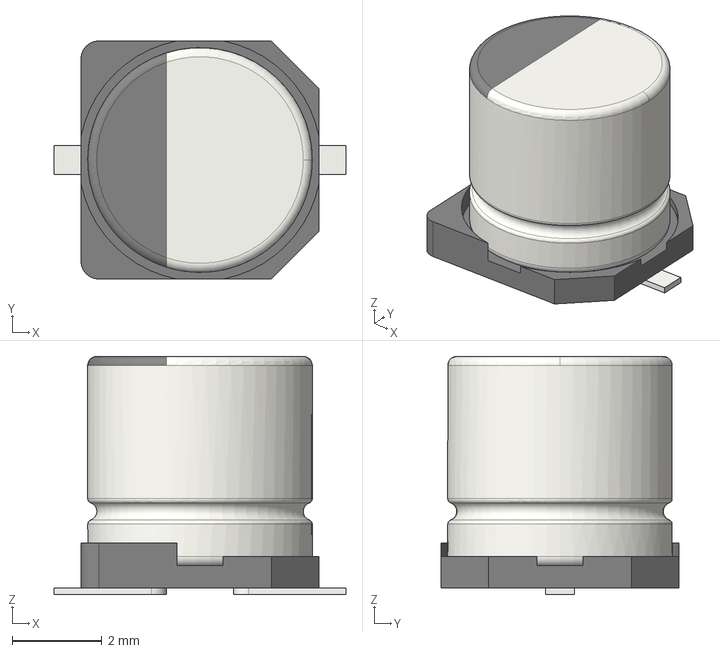
[picture p88: CAD file, 2017-06-21]
_3Dmodels/Capacitors_Radial_SMD/CP_Elec_5x5.3.step
6.50 x 5.30 x 5.30 mm
