Roboy/kicad_db/_3Dmodels/Capacitors_Radial_THT/CP_Radial_D35.0mm_P10.00mm_SnapIn.step

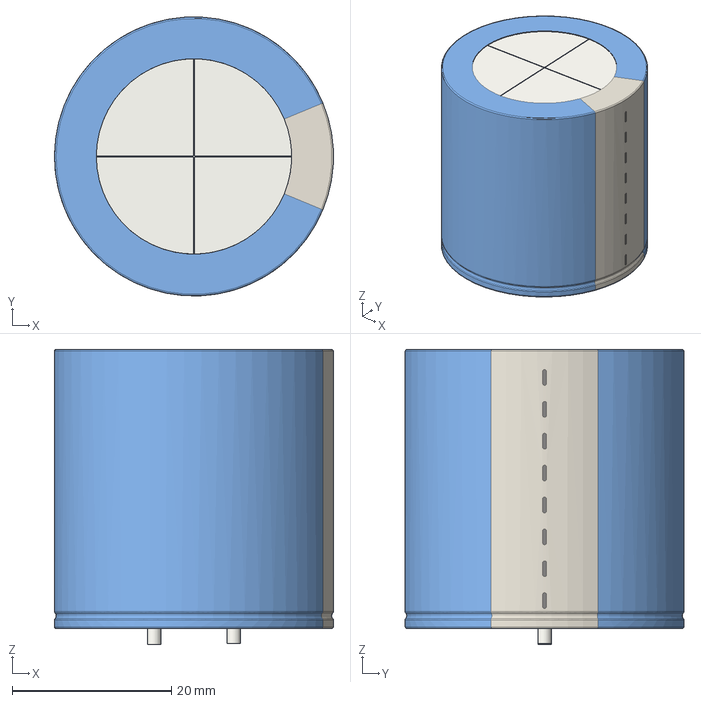
[picture p89: CAD file, 2017-06-21]
_3Dmodels/Capacitors_Radial_THT/CP_Radial_D35.0mm_P10.00mm_SnapIn.step
35.0 x 35.0 x 37.0 mm
