Roboy/kicad_db/_3Dmodels/Capacitors_Rect_THT/C_Rect_L31.5mm_W20.0mm_P27.50mm_MKS4.step

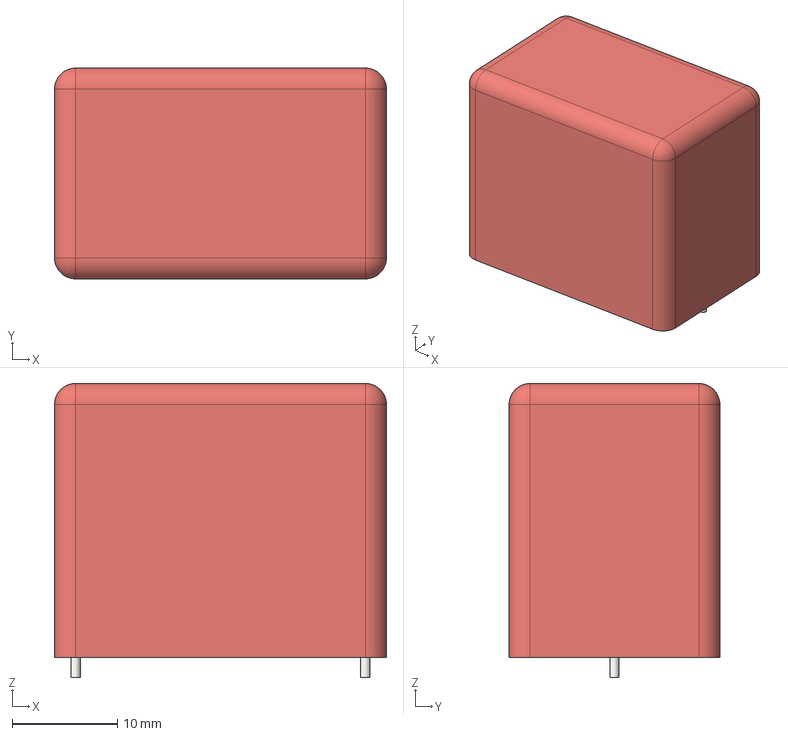
[picture p90: CAD file, 2017-06-21]
_3Dmodels/Capacitors_Rect_THT/C_Rect_L31.5mm_W20.0mm_P27.50mm_MKS4.step
31.5 x 20.0 x 27.9 mm
