Roboy/kicad_db/_3Dmodels/DIP_packages/DIP-14_W7.62mm.step

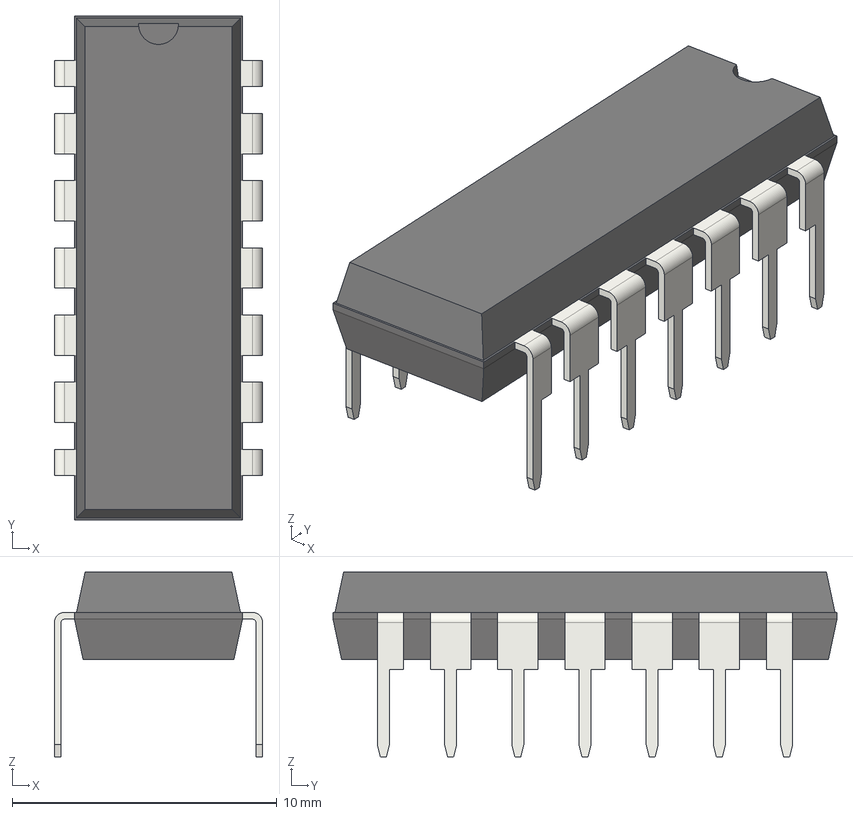
[picture p91: CAD file, 2017-06-21]
_3Dmodels/DIP_packages/DIP-14_W7.62mm.step
7.87 x 19.1 x 6.98 mm
