Roboy/kicad_db/_3Dmodels/GullWings_packages/QFP/TQFP-128_14x14mm_Pitch0.4mm.step

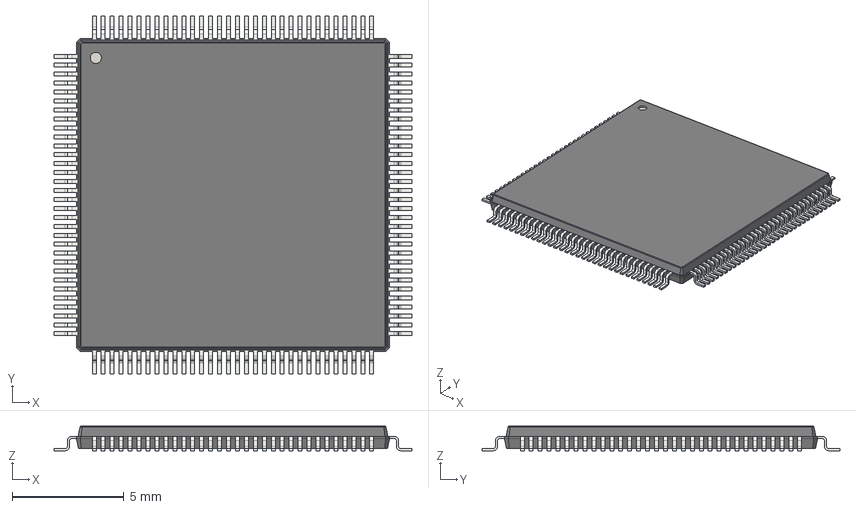
[picture p92: CAD file, 2017-06-21]
_3Dmodels/GullWings_packages/QFP/TQFP-128_14x14mm_Pitch0.4mm.step
16.0 x 16.0 x 1.10 mm
