Roboy/kicad_db/_3Dmodels/GullWings_packages/SOIC/SOIC-18W_7.5x11.6mm_Pitch1.27mm.step

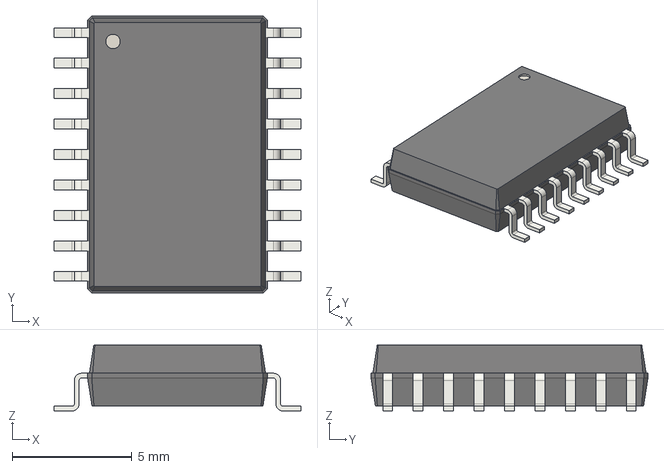
[picture p93: CAD file, 2017-06-21]
_3Dmodels/GullWings_packages/SOIC/SOIC-18W_7.5x11.6mm_Pitch1.27mm.step
10.3 x 11.6 x 2.75 mm
