Roboy/kicad_db/_3Dmodels/BGA_packages/BGA-121_11x11_12.0x12.0mm_Pitch1.0mm.step

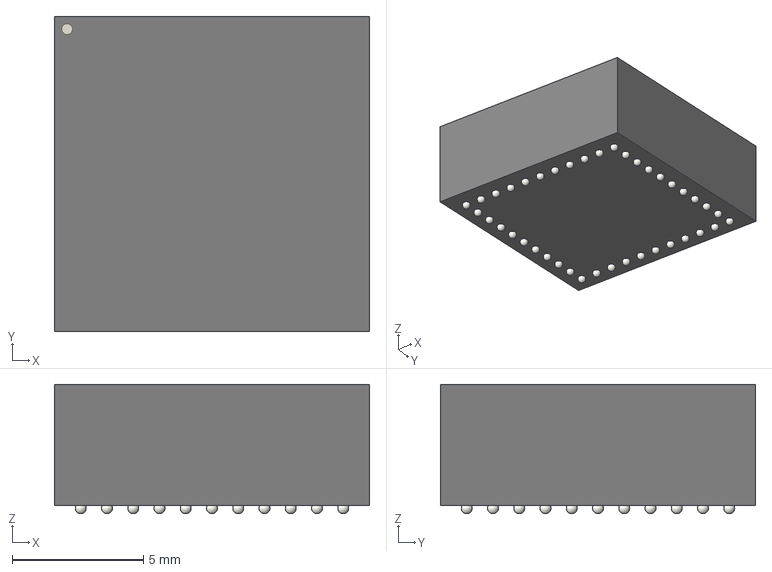
[picture p94: CAD file, 2017-06-21]
_3Dmodels/BGA_packages/BGA-121_11x11_12.0x12.0mm_Pitch1.0mm.step
12.0 x 12.0 x 4.93 mm
