Roboy/kicad_db/_3Dmodels/Capacitors_Radial_SMD/CP_Elec_4x5.3.step

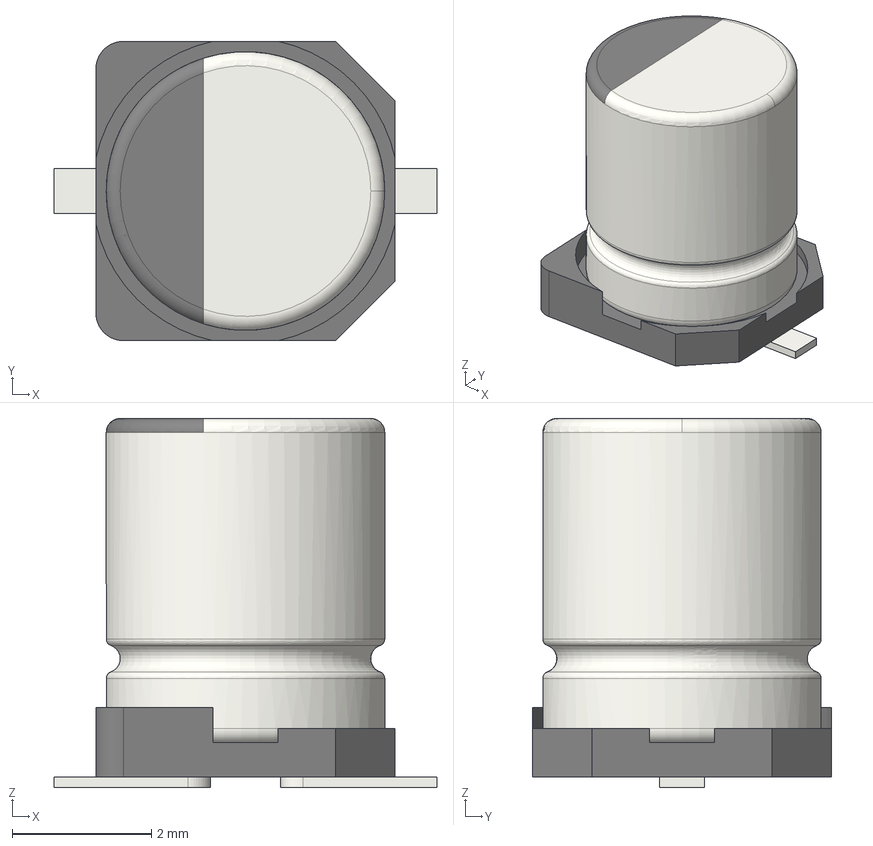
[picture p96: CAD file, 2017-06-21]
_3Dmodels/Capacitors_Radial_SMD/CP_Elec_4x5.3.step
5.50 x 4.30 x 5.30 mm
