Roboy/kicad_db/_3Dmodels/DIP_packages/DIP-6_W10.16mm.step

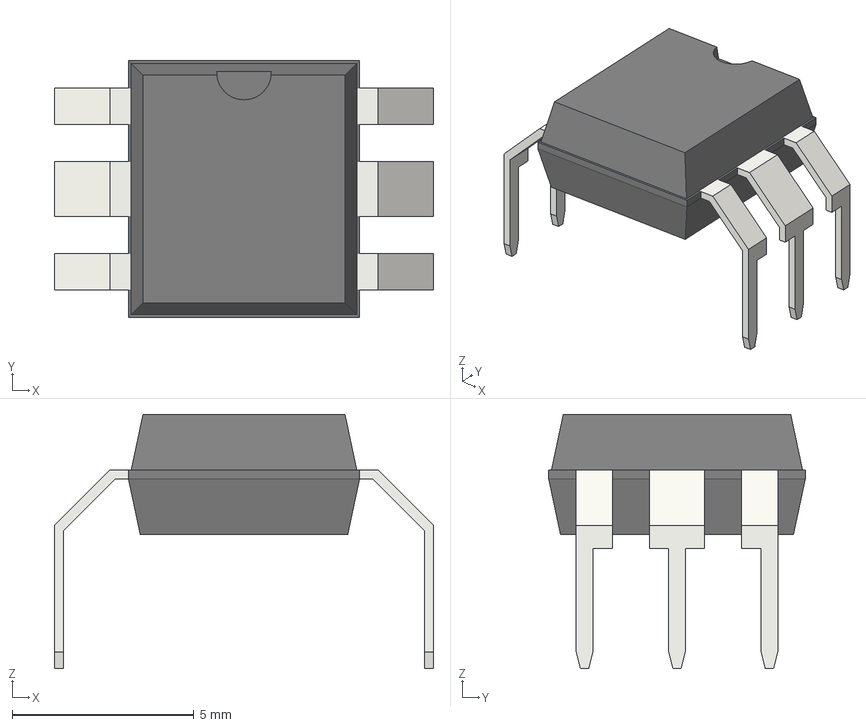
[picture p98: CAD file, 2017-06-21]
_3Dmodels/DIP_packages/DIP-6_W10.16mm.step
10.4 x 7.05 x 6.98 mm
