Roboy/kicad_db/_3Dmodels/GullWings_packages/QFP/LQFP-216_24x24mm_Pitch0.4mm.FCStd

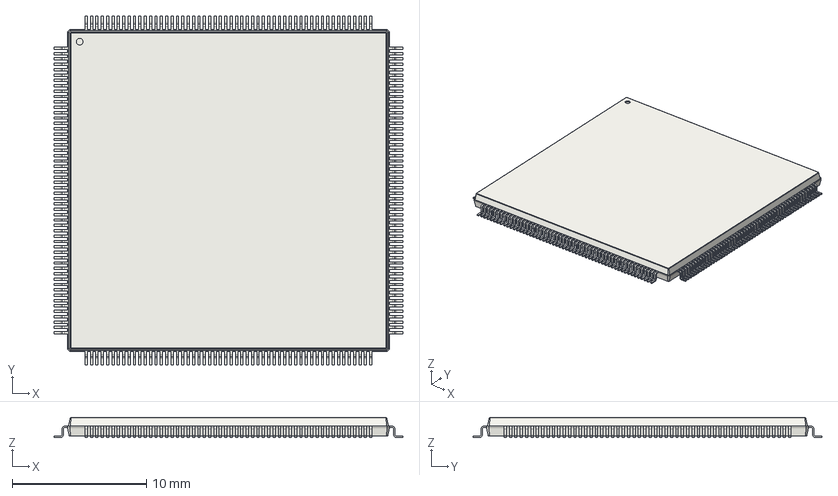
[picture p99: CAD file, 2017-06-21]
_3Dmodels/GullWings_packages/QFP/LQFP-216_24x24mm_Pitch0.4mm.FCStd
26.0 x 26.0 x 1.50 mm
