Roboy/kicad_db/_3Dmodels/Capacitors_Radial_SMD/CP_Elec_3x5.3.step

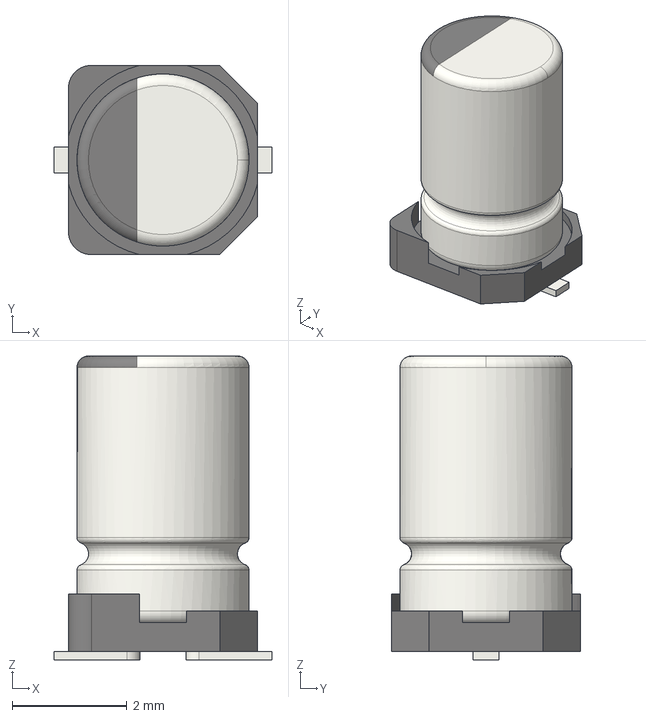
[picture p102: CAD file, 2017-06-21]
_3Dmodels/Capacitors_Radial_SMD/CP_Elec_3x5.3.step
3.80 x 3.30 x 5.30 mm
