Roboy/kicad_db/_3Dmodels/Capacitors_Radial_THT/CP_Radial_D24.0mm_P10.00mm_3pin_SnapIn.step

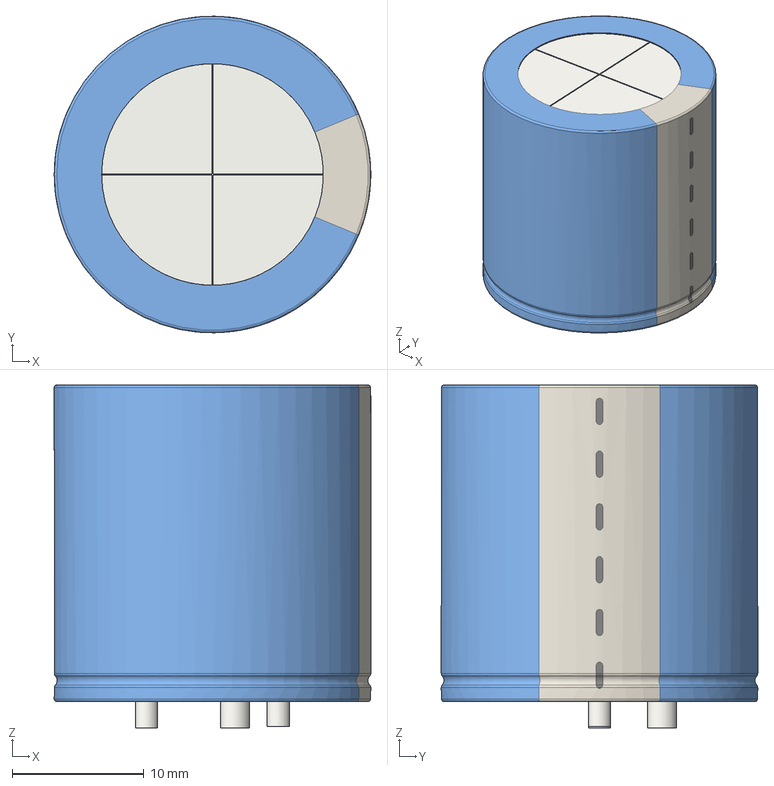
[picture p103: CAD file, 2017-06-21]
_3Dmodels/Capacitors_Radial_THT/CP_Radial_D24.0mm_P10.00mm_3pin_SnapIn.step
24.0 x 24.0 x 26.0 mm
