Roboy/kicad_db/_3Dmodels/Capacitors_Rect_THT/C_Rect_L10.0mm_W2.5mm_P7.50mm_MKS4.step

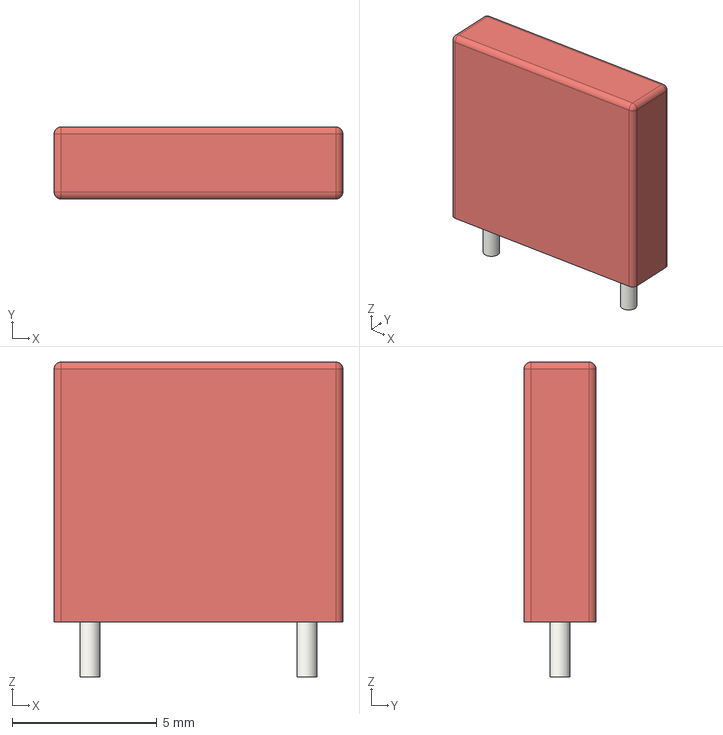
[picture p104: CAD file, 2017-06-21]
_3Dmodels/Capacitors_Rect_THT/C_Rect_L10.0mm_W2.5mm_P7.50mm_MKS4.step
10.0 x 2.50 x 10.9 mm
