Roboy/kicad_db/_3Dmodels/DIP_packages/DIP-24_W7.62mm.step

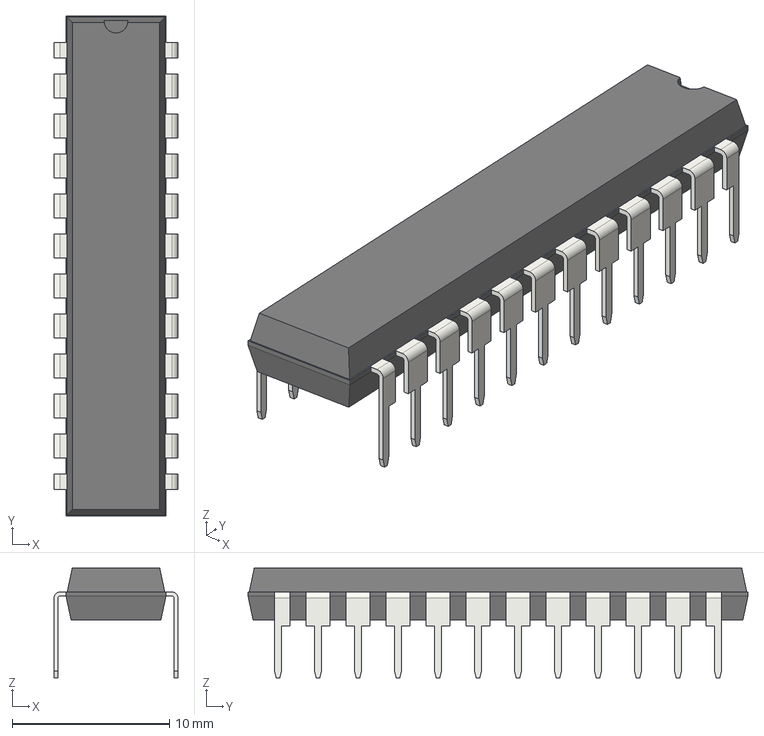
[picture p105: CAD file, 2017-06-21]
_3Dmodels/DIP_packages/DIP-24_W7.62mm.step
7.87 x 31.8 x 6.98 mm
