Roboy/kicad_db/_3Dmodels/BGA_packages/BGA-16_4x4_1.92x1.92mm_Pitch0.5mm.step

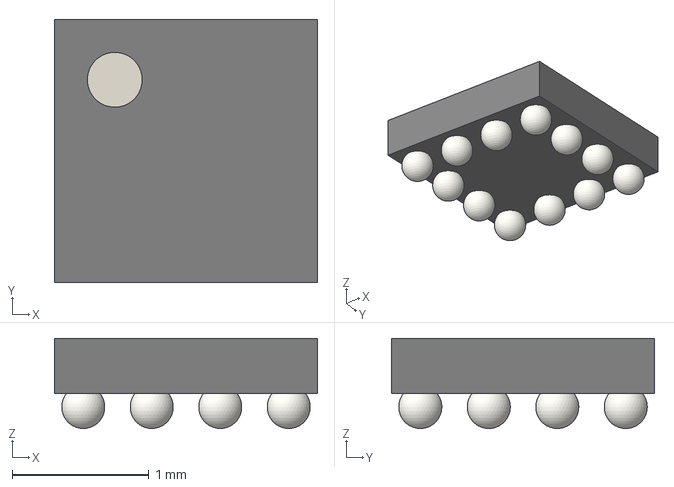
[picture p106: CAD file, 2017-06-21]
_3Dmodels/BGA_packages/BGA-16_4x4_1.92x1.92mm_Pitch0.5mm.step
1.92 x 1.92 x 0.657 mm
