Roboy/kicad_db/_3Dmodels/Box_Headers/Box_Header_Straight_2x08x2.54mm.step

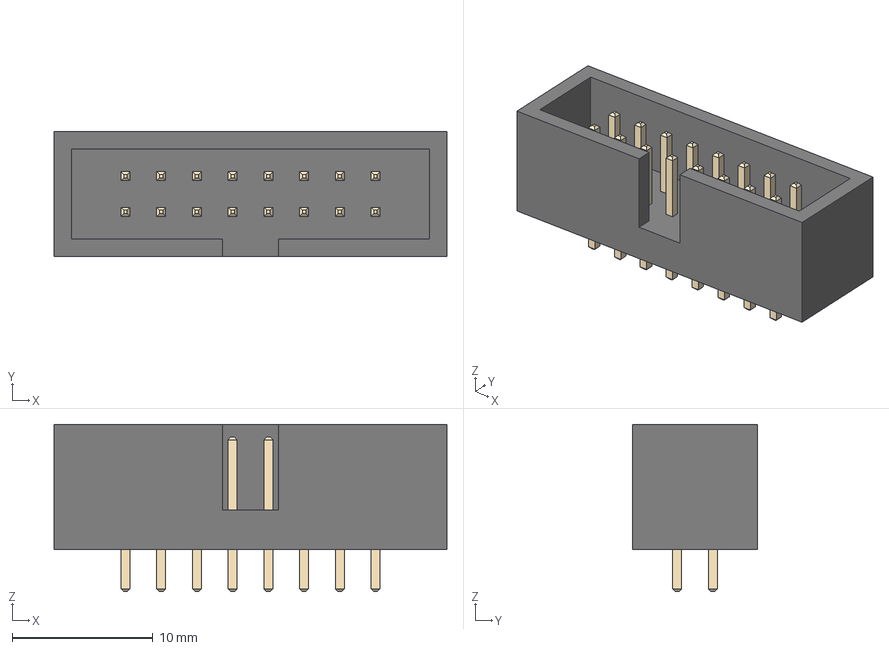
[picture p107: CAD file, 2017-06-21]
_3Dmodels/Box_Headers/Box_Header_Straight_2x08x2.54mm.step
27.9 x 8.90 x 11.9 mm
