Roboy/kicad_db/_3Dmodels/Capacitors_Radial_SMD/CP_Elec_8x5.4.step

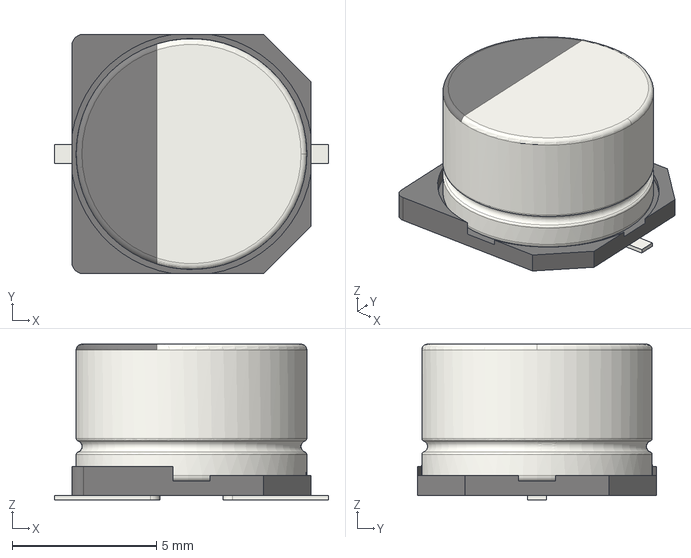
[picture p108: CAD file, 2017-06-21]
_3Dmodels/Capacitors_Radial_SMD/CP_Elec_8x5.4.step
9.50 x 8.30 x 5.40 mm
