Roboy/kicad_db/_3Dmodels/GullWings_packages/QFP/LQFP-160_24x24mm_Pitch0.5mm.FCStd

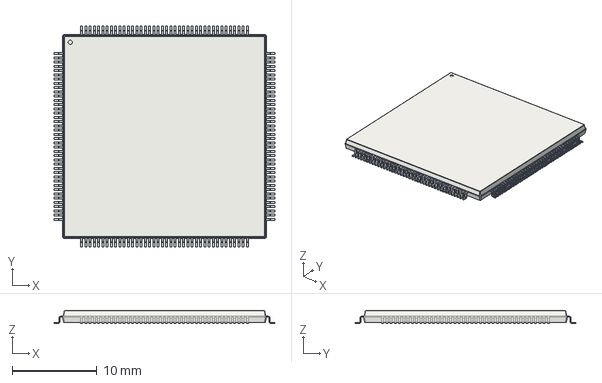
[picture p111: CAD file, 2017-06-21]
_3Dmodels/GullWings_packages/QFP/LQFP-160_24x24mm_Pitch0.5mm.FCStd
26.0 x 26.0 x 1.50 mm
