Roboy/kicad_db/_3Dmodels/BGA_packages/BGA-1295_36x36_37.5x37.5mm_Pitch1.0mm.step

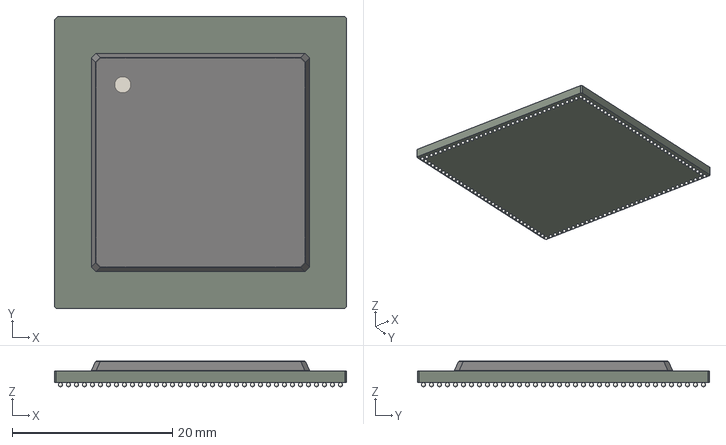
[picture p112: CAD file, 2017-06-21]
_3Dmodels/BGA_packages/BGA-1295_36x36_37.5x37.5mm_Pitch1.0mm.step
36.5 x 36.5 x 3.20 mm
