Roboy/kicad_db/_3Dmodels/Capacitors_Rect_THT/C_Rect_L7.2mm_W3.5mm_P5.00mm_FKS2_FKP2_MKS2_MKP2.step

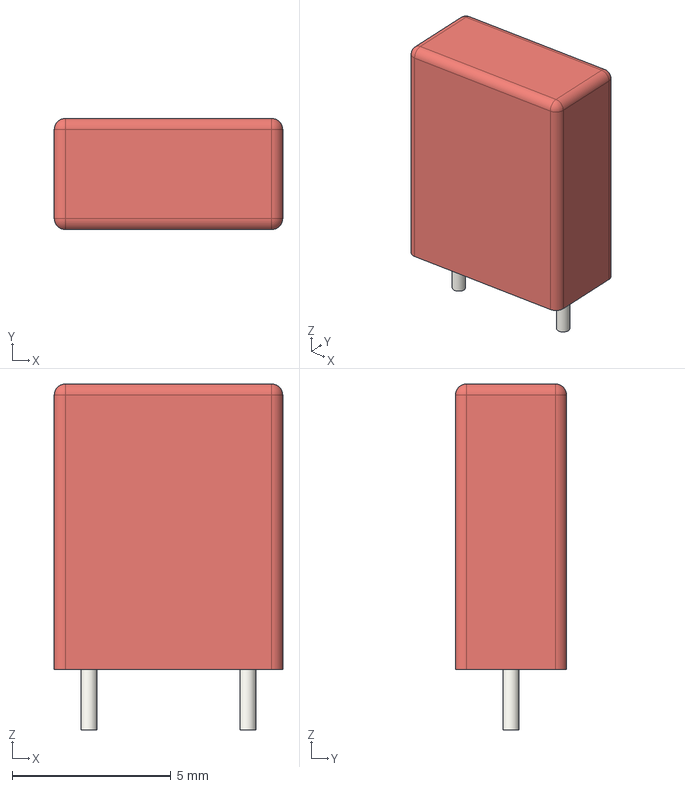
[picture p116: CAD file, 2017-06-21]
_3Dmodels/Capacitors_Rect_THT/C_Rect_L7.2mm_W3.5mm_P5.00mm_FKS2_FKP2_MKS2_MKP2.step
7.20 x 3.50 x 10.9 mm
