Roboy/kicad_db/_3Dmodels/DIP_packages/DIP-28_W15.24mm.step

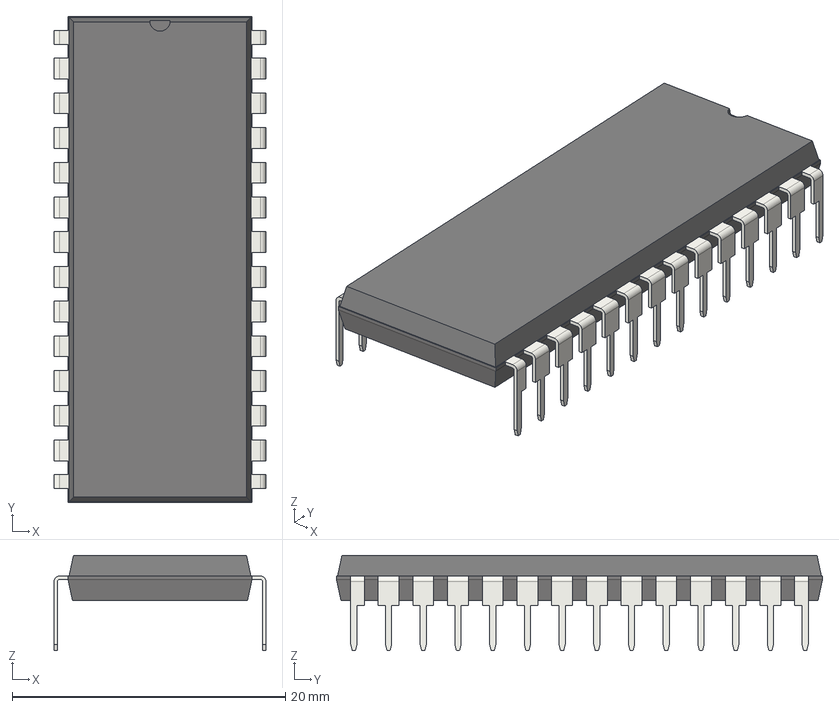
[picture p117: CAD file, 2017-06-21]
_3Dmodels/DIP_packages/DIP-28_W15.24mm.step
15.5 x 35.6 x 6.98 mm
