Roboy/kicad_db/_3Dmodels/GullWings_packages/QFP/TQFP-144_16x16mm_Pitch0.4mm.step

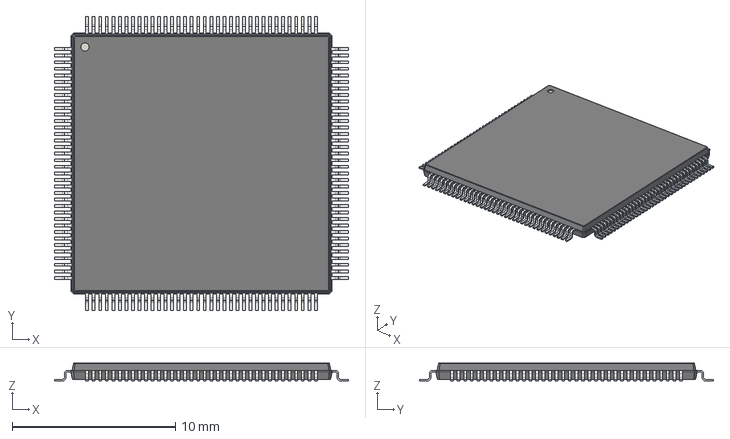
[picture p118: CAD file, 2017-06-21]
_3Dmodels/GullWings_packages/QFP/TQFP-144_16x16mm_Pitch0.4mm.step
18.0 x 18.0 x 1.10 mm
