Roboy/kicad_db/_3Dmodels/BGA_packages/BGA-256_16x16_17.0x17.0mm_Pitch1.0mm.step

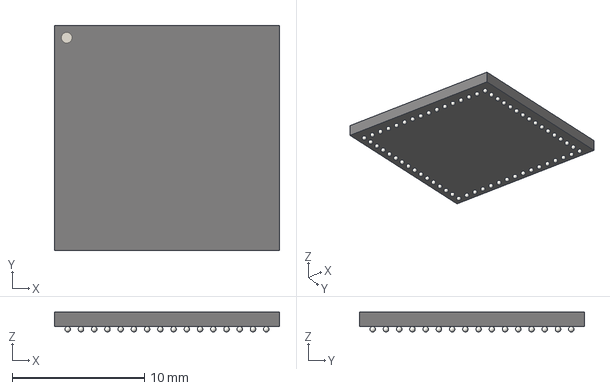
[picture p119: CAD file, 2017-06-21]
_3Dmodels/BGA_packages/BGA-256_16x16_17.0x17.0mm_Pitch1.0mm.step
17.0 x 17.0 x 1.51 mm
