Roboy/kicad_db/_3Dmodels/Capacitors_Radial_SMD/CP_Elec_4x5.8.step

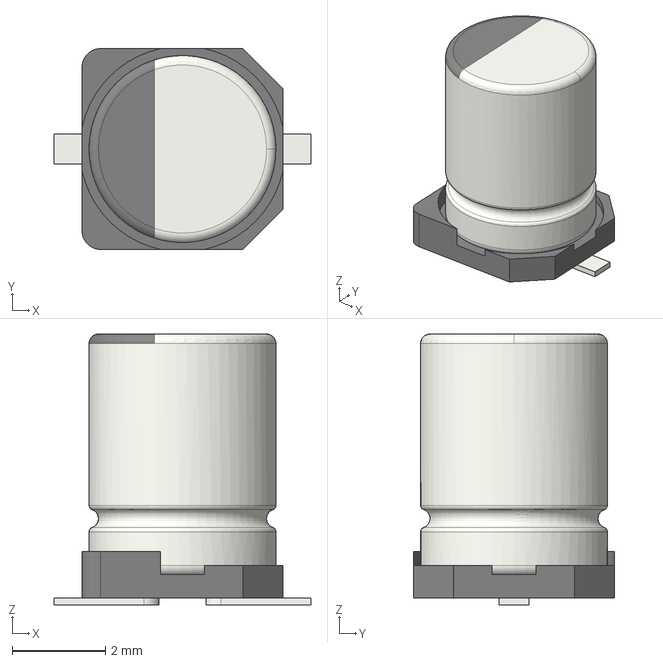
[picture p121: CAD file, 2017-06-21]
_3Dmodels/Capacitors_Radial_SMD/CP_Elec_4x5.8.step
5.50 x 4.30 x 5.80 mm
