Roboy/kicad_db/_3Dmodels/Capacitors_Rect_THT/C_Rect_L11.5mm_W5.6mm_P10.00mm_MKT.step

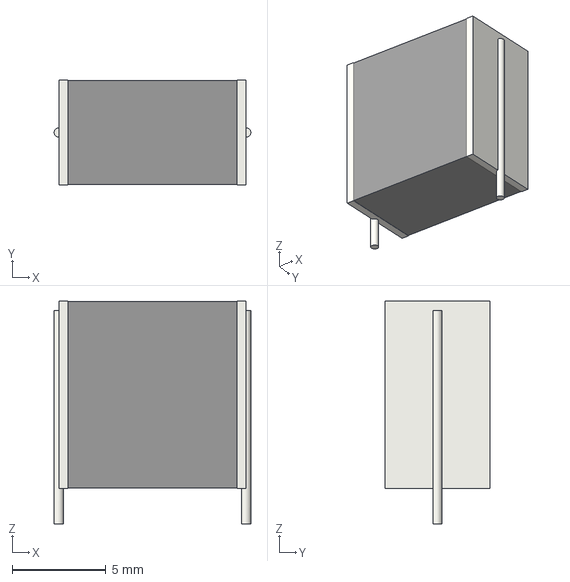
[picture p122: CAD file, 2017-06-21]
_3Dmodels/Capacitors_Rect_THT/C_Rect_L11.5mm_W5.6mm_P10.00mm_MKT.step
10.5 x 5.60 x 11.9 mm
