Roboy/kicad_db/_3Dmodels/DIP_packages/DIP-18_W7.62mm.step

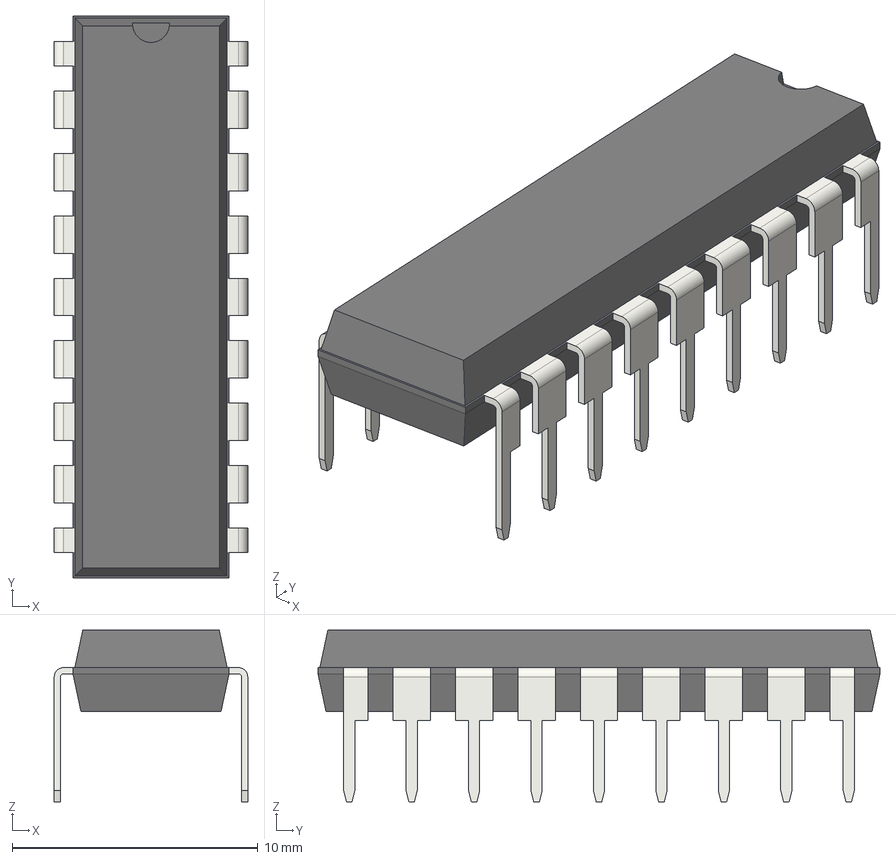
[picture p123: CAD file, 2017-06-21]
_3Dmodels/DIP_packages/DIP-18_W7.62mm.step
7.87 x 22.9 x 6.98 mm
