Roboy/kicad_db/_3Dmodels/Capacitors_Radial_SMD/CP_Elec_10x7.7.step

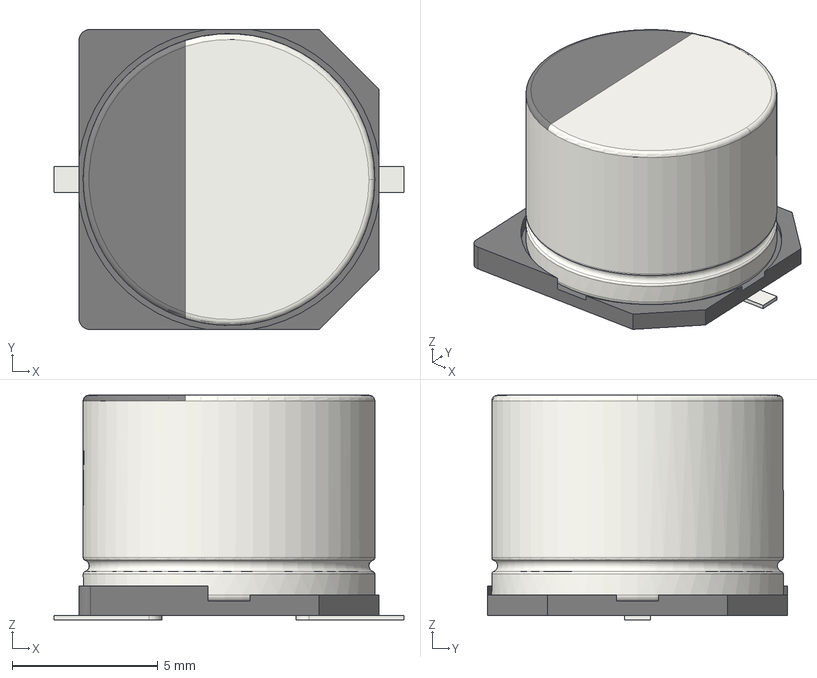
[picture p127: CAD file, 2017-06-21]
_3Dmodels/Capacitors_Radial_SMD/CP_Elec_10x7.7.step
12.0 x 10.3 x 7.70 mm
