Roboy/kicad_db/_3Dmodels/Capacitors_Radial_THT/CP_Radial_D12.5mm_P2.50mm.step

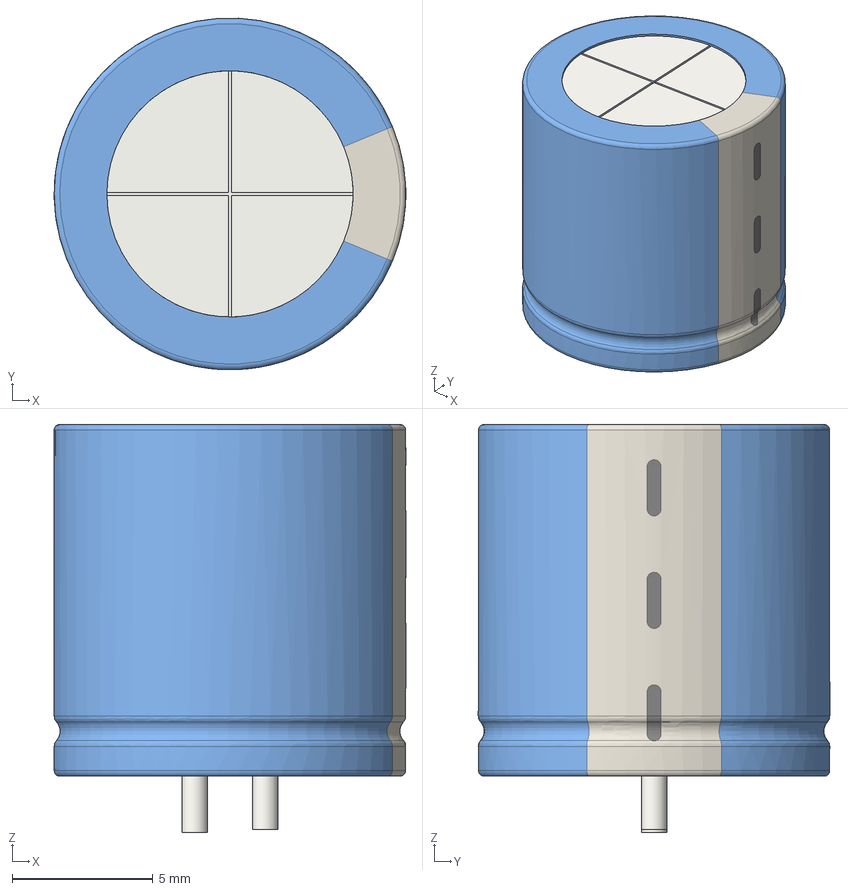
[picture p128: CAD file, 2017-06-21]
_3Dmodels/Capacitors_Radial_THT/CP_Radial_D12.5mm_P2.50mm.step
12.5 x 12.5 x 14.5 mm
