Roboy/kicad_db/_3Dmodels/Capacitors_Rect_THT/C_Rect_L19.0mm_W5.0mm_P15.00mm_MKS4.step

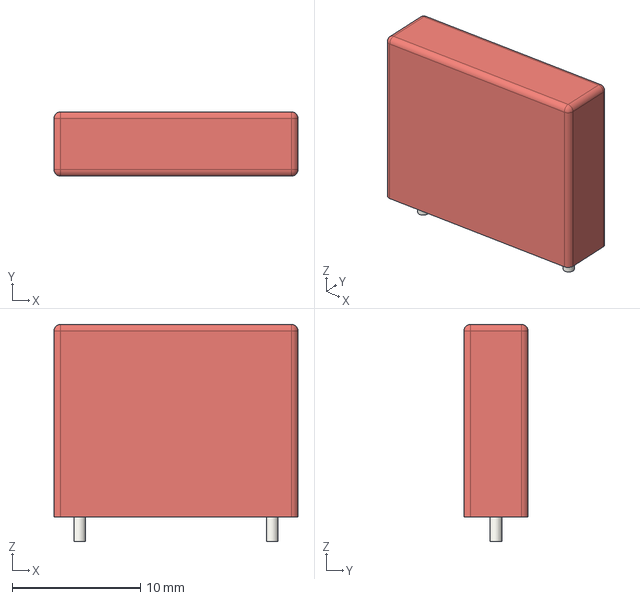
[picture p129: CAD file, 2017-06-21]
_3Dmodels/Capacitors_Rect_THT/C_Rect_L19.0mm_W5.0mm_P15.00mm_MKS4.step
19.0 x 5.00 x 16.9 mm
