Roboy/kicad_db/_3Dmodels/GullWings_packages/QFP/TQFP-48_7x7mm_Pitch0.5mm.step

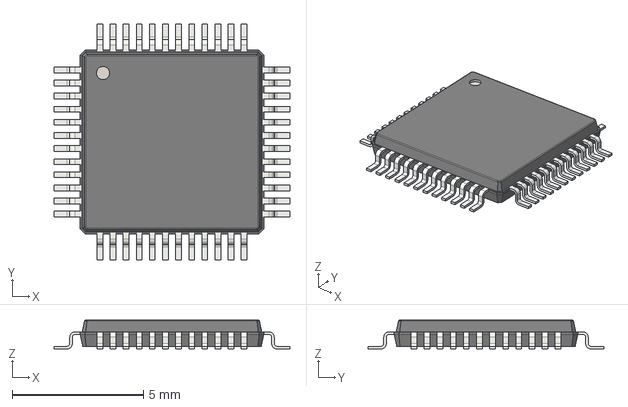
[picture p131: CAD file, 2017-06-21]
_3Dmodels/GullWings_packages/QFP/TQFP-48_7x7mm_Pitch0.5mm.step
9.00 x 9.00 x 1.10 mm
