Roboy/kicad_db/_3Dmodels/Capacitors_Radial_SMD/CP_Elec_6.3x4.5.step

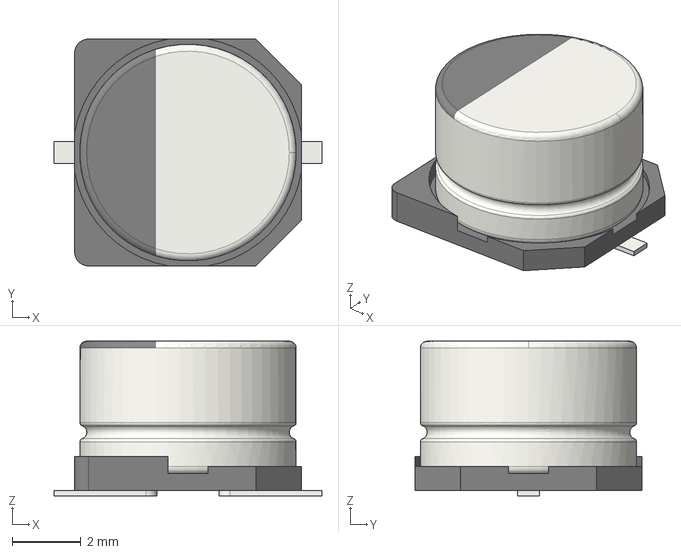
[picture p134: CAD file, 2017-06-21]
_3Dmodels/Capacitors_Radial_SMD/CP_Elec_6.3x4.5.step
7.80 x 6.60 x 4.50 mm
