Roboy/kicad_db/_3Dmodels/Capacitors_Rect_THT/C_Rect_L13.0mm_W8.0mm_P10.00mm_FKS3_FKP3_MKS4.step

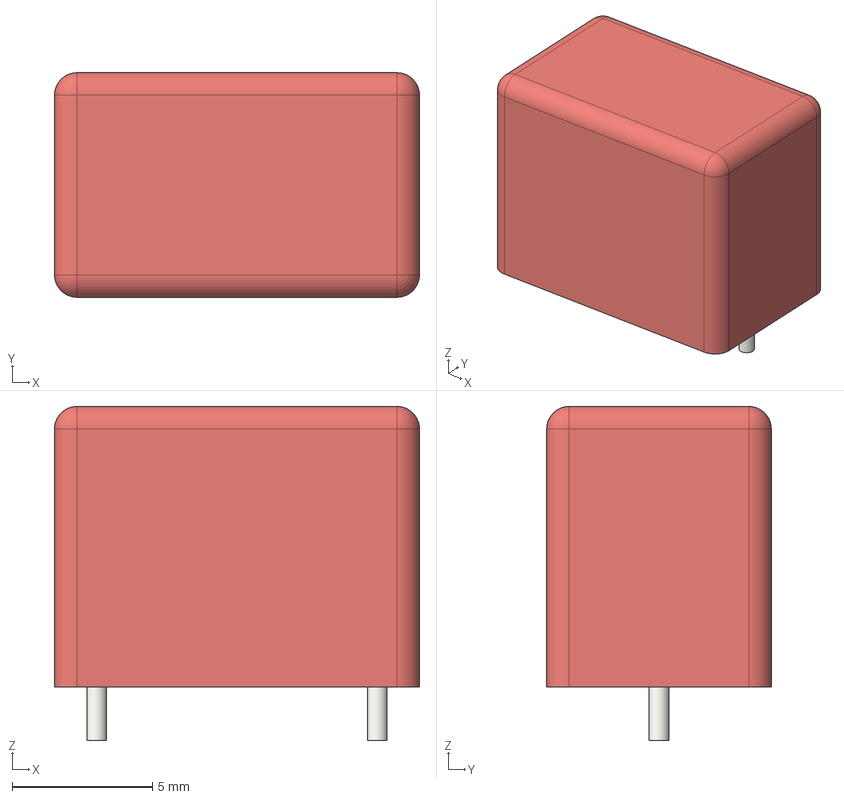
[picture p136: CAD file, 2017-06-21]
_3Dmodels/Capacitors_Rect_THT/C_Rect_L13.0mm_W8.0mm_P10.00mm_FKS3_FKP3_MKS4.step
13.0 x 8.00 x 11.9 mm
