Roboy/kicad_db/_3Dmodels/BGA_packages/BGA-96_2x3x16_9.0x13.0mm_Pitch0.8mm.step

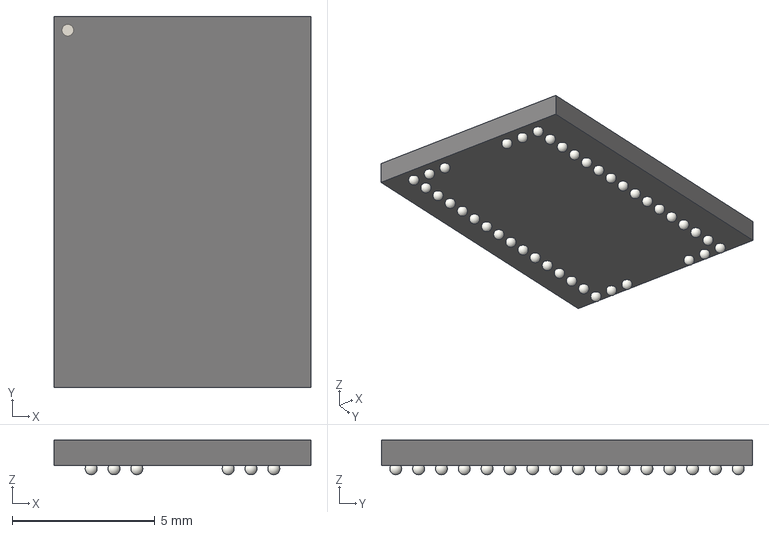
[picture p139: CAD file, 2017-06-21]
_3Dmodels/BGA_packages/BGA-96_2x3x16_9.0x13.0mm_Pitch0.8mm.step
9.00 x 13.0 x 1.21 mm
