Roboy/kicad_db/(list of files, cad)

Other CAD files:
_3Dmodels/Capacitors_Radial_THT/CP_Radial_D10.0mm_P2.50mm.step
_3Dmodels/Capacitors_Radial_THT/CP_Radial_D25.0mm_P10.00mm_SnapIn.step
_3Dmodels/Capacitors_Radial_SMD/CP_Elec_10x10.5.step
_3Dmodels/Capacitors_Radial_THT/CP_Radial_D10.0mm_P2.50mm_P5.00mm.step
_3Dmodels/BGA_packages/BGA-64_10x10_9.0x9.0mm_Pitch0.8mm.step
_3Dmodels/Capacitors_Radial_THT/CP_Radial_D22.0mm_P10.00mm_3pin_SnapIn.step
_3Dmodels/GullWings_packages/QFP/TQFP-64_1EP_10x10mm_Pitch0.5mm.step
_3Dmodels/Capacitors_Radial_THT/CP_Radial_D13.0mm_P2.50mm.step
_3Dmodels/Capacitors_Radial_THT/CP_Radial_D10.0mm_P3.50mm.step
_3Dmodels/Capacitors_Radial_SMD/CP_Elec_10x10.step
_3Dmodels/4UCON_17809/4UCON_17809_02x10x1.27mm_Vertical.FCStd
_3Dmodels/BGA_packages/BGA-100_10x10_9.0x9.0mm_Pitch0.8mm.FCStd
_3Dmodels/BGA_packages/BGA-1023_32x32_33.0x33.0mm_Pitch1.0mm.FCStd
_3Dmodels/BGA_packages/BGA-1156_34x34_35.0x35.0mm_Pitch1.0mm.FCStd
_3Dmodels/BGA_packages/BGA-121_11x11_12.0x12.0mm_Pitch1.0mm.FCStd
_3Dmodels/BGA_packages/BGA-1295_36x36_37.5x37.5mm_Pitch1.0mm.FCStd
_3Dmodels/BGA_packages/BGA-144_12x12_13.0x13.0mm_Pitch1.0mm.FCStd
_3Dmodels/BGA_packages/BGA-16_4x4_1.92x1.92mm_Pitch0.5mm.FCStd
_3Dmodels/BGA_packages/BGA-256_16x16_17.0x17.0mm_Pitch1.0mm.FCStd
_3Dmodels/BGA_packages/BGA-25_5x5_6.35x6.35mm_Pitch1.27mm.FCStd
_3Dmodels/BGA_packages/BGA-352_26x26_35.0x35.0mm_Pitch1.27mm.FCStd
_3Dmodels/BGA_packages/BGA-352_26x26_35.0x35.0mm_Pitch1.27mm.step
_3Dmodels/BGA_packages/BGA-400_20x20_21.0x21.0mm_Pitch1.0mm.FCStd
_3Dmodels/BGA_packages/BGA-484_22x22_23.0x23.0mm_Pitch1.0mm.FCStd
_3Dmodels/BGA_packages/BGA-48_6x8_8.0x9.0mm_Pitch0.8mm.FCStd
_3Dmodels/BGA_packages/BGA-625_25x25_21.0x21.0mm_Pitch0.8mm.FCStd
_3Dmodels/BGA_packages/BGA-64_10x10_9.0x9.0mm_Pitch0.8mm.FCStd
_3Dmodels/BGA_packages/BGA-90_2x3x15_8.0x13.0mm_Pitch0.8mm.FCStd
_3Dmodels/BGA_packages/BGA-96_2x3x16_9.0x13.0mm_Pitch0.8mm.FCStd
_3Dmodels/BGA_packages/BGA-9_3x3_1.6x1.6mm_Pitch0.5mm.FCStd
_3Dmodels/BGA_packages/DSBGA-12_3x4_1.36x1.86mm_Pitch0.5mm_Dia0.25mm.FCStd
_3Dmodels/BGA_packages/DSBGA-8_2x4_0.9x1.9mm_Pitch0.5mm_Dia0.25mm.FCStd
_3Dmodels/BGA_packages/DSBGA-8_2x4_0.9x1.9mm_Pitch0.5mm_Dia0.25mm.step
_3Dmodels/BGA_packages/Maxim_WLP-12_4x3_2.0x1.56mm_Pitch0.5mm.FCStd
_3Dmodels/BGA_packages/Maxim_WLP-12_4x3_2.0x1.56mm_Pitch0.5mm.step
_3Dmodels/BGA_packages/Texas_Junior_DSBGA-12_4x3_2.5x2.0mm_Pitch0.5mm_Dia0.30mm.FCStd
_3Dmodels/Box_Headers/Box_Header_Straight_2x02x2.54mm.FCStd
_3Dmodels/Box_Headers/Box_Header_Straight_2x03x2.54mm.FCStd
_3Dmodels/Box_Headers/Box_Header_Straight_2x04x2.54mm.FCStd
_3Dmodels/Box_Headers/Box_Header_Straight_2x05x2.54mm.FCStd
_3Dmodels/Box_Headers/Box_Header_Straight_2x06x2.54mm.FCStd
_3Dmodels/Box_Headers/Box_Header_Straight_2x07x2.54mm.FCStd
_3Dmodels/Box_Headers/Box_Header_Straight_2x07x2.54mm.step
_3Dmodels/Box_Headers/Box_Header_Straight_2x08x2.54mm.FCStd
_3Dmodels/Box_Headers/Box_Header_Straight_2x09x2.54mm.FCStd
_3Dmodels/Box_Headers/Box_Header_Straight_2x09x2.54mm.step
_3Dmodels/Box_Headers/Box_Header_Straight_2x10x2.54mm.FCStd
_3Dmodels/Box_Headers/Box_Header_Straight_2x10x2.54mm.step
_3Dmodels/Box_Headers/Box_Header_Straight_2x11x2.54mm.FCStd
_3Dmodels/Box_Headers/Box_Header_Straight_2x12x2.54mm.FCStd
_3Dmodels/Box_Headers/Box_Header_Straight_2x12x2.54mm.step
_3Dmodels/Box_Headers/Box_Header_Straight_2x13x2.54mm.FCStd
_3Dmodels/Box_Headers/Box_Header_Straight_2x13x2.54mm.step
_3Dmodels/Box_Headers/Box_Header_Straight_2x14x2.54mm.FCStd
_3Dmodels/Box_Headers/Box_Header_Straight_2x15x2.54mm.FCStd
_3Dmodels/Box_Headers/Box_Header_Straight_2x15x2.54mm.step
_3Dmodels/Box_Headers/Box_Header_Straight_2x16x2.54mm.FCStd
_3Dmodels/Box_Headers/Box_Header_Straight_2x16x2.54mm.step
_3Dmodels/Box_Headers/Box_Header_Straight_2x17x2.54mm.FCStd
_3Dmodels/Box_Headers/Box_Header_Straight_2x18x2.54mm.FCStd
_3Dmodels/Box_Headers/Box_Header_Straight_2x18x2.54mm.step
_3Dmodels/Box_Headers/Box_Header_Straight_2x19x2.54mm.FCStd
_3Dmodels/Box_Headers/Box_Header_Straight_2x19x2.54mm.step
_3Dmodels/Box_Headers/Box_Header_Straight_2x20x2.54mm.FCStd
_3Dmodels/Box_Headers/Box_Header_Straight_2x21x2.54mm.FCStd
_3Dmodels/Box_Headers/Box_Header_Straight_2x21x2.54mm.step
_3Dmodels/Box_Headers/Box_Header_Straight_2x22x2.54mm.FCStd
_3Dmodels/Box_Headers/Box_Header_Straight_2x22x2.54mm.step
_3Dmodels/Box_Headers/Box_Header_Straight_2x23x2.54mm.FCStd
_3Dmodels/Box_Headers/Box_Header_Straight_2x23x2.54mm.step
_3Dmodels/Box_Headers/Box_Header_Straight_2x24x2.54mm.FCStd
_3Dmodels/Box_Headers/Box_Header_Straight_2x25x2.54mm.FCStd
_3Dmodels/Box_Headers/Box_Header_Straight_2x26x2.54mm.FCStd
_3Dmodels/Box_Headers/Box_Header_Straight_2x26x2.54mm.step
_3Dmodels/Box_Headers/Box_Header_Straight_2x27x2.54mm.FCStd
_3Dmodels/Box_Headers/Box_Header_Straight_2x28x2.54mm.FCStd
_3Dmodels/Box_Headers/Box_Header_Straight_2x28x2.54mm.step
_3Dmodels/Box_Headers/Box_Header_Straight_2x29x2.54mm.FCStd
_3Dmodels/Box_Headers/Box_Header_Straight_2x30x2.54mm.FCStd
_3Dmodels/Box_Headers/Box_Header_Straight_2x30x2.54mm.step
_3Dmodels/Box_Headers/Box_Header_Straight_2x31x2.54mm.FCStd
_3Dmodels/Box_Headers/Box_Header_Straight_2x31x2.54mm.step
_3Dmodels/Box_Headers/Box_Header_Straight_2x32x2.54mm.FCStd
_3Dmodels/Box_Headers/Box_Header_Straight_2x33x2.54mm.FCStd
_3Dmodels/Box_Headers/Box_Header_Straight_2x33x2.54mm.step
_3Dmodels/Box_Headers/Box_Header_Straight_2x34x2.54mm.FCStd
_3Dmodels/Box_Headers/Box_Header_Straight_2x35x2.54mm.FCStd
_3Dmodels/Box_Headers/Box_Header_Straight_2x35x2.54mm.step
_3Dmodels/Box_Headers/Box_Header_Straight_2x36x2.54mm.FCStd
_3Dmodels/Box_Headers/Box_Header_Straight_2x37x2.54mm.FCStd
_3Dmodels/Box_Headers/Box_Header_Straight_2x38x2.54mm.FCStd
_3Dmodels/Box_Headers/Box_Header_Straight_2x38x2.54mm.step
_3Dmodels/Box_Headers/Box_Header_Straight_2x39x2.54mm.FCStd
_3Dmodels/Box_Headers/Box_Header_Straight_2x40x2.54mm.FCStd
_3Dmodels/Box_Headers/Box_Header_Straight_2x40x2.54mm.step
_3Dmodels/Capacitors_Radial_SMD/CP_Elec_10x10.5.FCStd
_3Dmodels/Capacitors_Radial_SMD/CP_Elec_10x10.FCStd
_3Dmodels/Capacitors_Radial_SMD/CP_Elec_10x7.7.FCStd
_3Dmodels/Capacitors_Radial_SMD/CP_Elec_3x5.3.FCStd
_3Dmodels/Capacitors_Radial_SMD/CP_Elec_4x4.5.FCStd
_3Dmodels/Capacitors_Radial_SMD/CP_Elec_4x5.3.FCStd
_3Dmodels/Capacitors_Radial_SMD/CP_Elec_4x5.7.FCStd
_3Dmodels/Capacitors_Radial_SMD/CP_Elec_4x5.8.FCStd
_3Dmodels/Capacitors_Radial_SMD/CP_Elec_5x4.5.FCStd
_3Dmodels/Capacitors_Radial_SMD/CP_Elec_5x5.3.FCStd
_3Dmodels/Capacitors_Radial_SMD/CP_Elec_5x5.7.FCStd
_3Dmodels/Capacitors_Radial_SMD/CP_Elec_5x5.7.step
_3Dmodels/Capacitors_Radial_SMD/CP_Elec_5x5.8.FCStd
_3Dmodels/Capacitors_Radial_SMD/CP_Elec_6.3x4.5.FCStd
_3Dmodels/Capacitors_Radial_SMD/CP_Elec_6.3x5.3.FCStd
_3Dmodels/Capacitors_Radial_SMD/CP_Elec_6.3x5.3.step
_3Dmodels/Capacitors_Radial_SMD/CP_Elec_6.3x5.7.FCStd
_3Dmodels/Capacitors_Radial_SMD/CP_Elec_6.3x5.8.FCStd
_3Dmodels/Capacitors_Radial_SMD/CP_Elec_6.3x7.7.FCStd
_3Dmodels/Capacitors_Radial_SMD/CP_Elec_6.3x7.7.step
_3Dmodels/Capacitors_Radial_SMD/CP_Elec_8x10.5.FCStd
_3Dmodels/Capacitors_Radial_SMD/CP_Elec_8x10.FCStd
_3Dmodels/Capacitors_Radial_SMD/CP_Elec_8x5.4.FCStd
_3Dmodels/Capacitors_Radial_SMD/CP_Elec_8x6.5.FCStd
_3Dmodels/Capacitors_Radial_SMD/CP_Elec_8x6.7.FCStd
_3Dmodels/Capacitors_Radial_THT/CP_Radial_D10.0mm_P2.50mm.FCStd
_3Dmodels/Capacitors_Radial_THT/CP_Radial_D10.0mm_P2.50mm_P5.00mm.FCStd
_3Dmodels/Capacitors_Radial_THT/CP_Radial_D10.0mm_P3.50mm.FCStd
_3Dmodels/Capacitors_Radial_THT/CP_Radial_D10.0mm_P3.80mm.FCStd
_3Dmodels/Capacitors_Radial_THT/CP_Radial_D10.0mm_P5.00mm.FCStd
_3Dmodels/Capacitors_Radial_THT/CP_Radial_D10.0mm_P5.00mm.step
_3Dmodels/Capacitors_Radial_THT/CP_Radial_D10.0mm_P5.00mm_P7.50mm.FCStd
_3Dmodels/Capacitors_Radial_THT/CP_Radial_D10.0mm_P5.00mm_P7.50mm.step
_3Dmodels/Capacitors_Radial_THT/CP_Radial_D10.0mm_P7.50mm.FCStd
_3Dmodels/Capacitors_Radial_THT/CP_Radial_D12.5mm_P2.50mm.FCStd
_3Dmodels/Capacitors_Radial_THT/CP_Radial_D12.5mm_P5.00mm.FCStd
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
