Roboy/kicad_db/(commit log)

2017-06-21 Initial commit. Added a custom component library, 3D exporter scripts and STEP models for a lot of components
    [4UCON_17809_02x10x1.27mm_Vertical.FCStd, 4UCON_17809_02x10x1.27mm_Vertical.step, 4UCON_17809_02x40x1.27mm_Vertical.FCStd, BGA-100_10x10_9.0x9.0mm_Pitch0.8mm.FCStd, BGA-100_10x10_9.0x9.0mm_Pitch0.8mm.step, BGA-1023_32x32_33.0x33.0mm_Pitch1.0mm.FCStd, BGA-1023_32x32_33.0x33.0mm_Pitch1.0mm.step, BGA-1156_34x34_35.0x35.0mm_Pitch1.0mm.FCStd]
2017-06-25 Added custom QFN32 package for the AM4096 magnetic sensor. Will upload modified generating script later.
2017-07-05 Added 3D models for both the new JST and TE-Connectivity connectors. Also generated the whole batch of JST connectors from the easyw repo just because. Finally added a cadquery_scripts folder to plac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
2017-07-05 Added custom footprint library and added schematic symbols for the JST connectors
2017-07-20 Designed correct footprints for the JST and TE-connectivity connectors, and reexported the stls to wrl for use in kicad
2017-07-30 Added TSOP-6 footprint for the Infineon 3D magnetic sensor.
2017-09-23 Added various components and footprints. To the custom library: TE Micro Match series 215079, in 4,6 and 10 positions. Infineon's TLE9879QX driver. Wago SMD series in 2 and 3 positions. Also added th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
2017-09-23 Corrected some footprints and added a dual RS422 receiver component.
2018-01-18 Added various footprints for diodes and LEDs, LGA for switches and level converters and also the SMD Wago connectors. Various additions also in the library (IMU, analog switches, level shifters ...).
2018-01-19 Added INA180 current amplifier for the arm board.
2018-01-20 My bad, last commit only included changes to the component library, where I added the symbols for the BMI160 IMU and the level converter. This commit finally adds the footprints for the diodes, LGA a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
2018-01-23 Deleted LGA footprints since more recent versions are present on the official kicad repo.
2018-01-23 Corrected JST connector pinout.
2018-02-03 Added new soldermask Roboy logo to footprints.
2018-05-28 Added new footprints and components for the motorboards and forearm boards, and corrected a few of the existing ones.
2019-01-22 Added quite a few components for the developement of the skin electronics. Most notably the new sidelooking LEDs, a footprint to solder FPC directly on to the board, and some ADCs/uControllers.
2019-02-11 with mosfet
2019-02-11 Corrected footprint FPC_0.5mmx10, so that pads have correct clearance to each other '(>6mil/0.152mm\!)'. Also added the footprint for a the FFC connector for this cable.
2019-05-12 more models
    [LED_WS2812B-PLCC4_3.5x3.5.step]
2019-06-15 with ti mosfet driver
2019-06-30 with current sensor TLI4970
2019-07-31 with ethernet phy schematics
2019-08-01 with correct clock footprint
2019-10-11 with shield footprint
2019-11-20 with dip switch and micromatch smt
2019-11-22 tactile switch, hex encoder
2019-11-22 with vishay optical encoder
2019-11-25 with optical encoder step
    [vishay_tcut1350x01.stp]
2019-12-03 bette footprint for optical encoder
    [ESP-WROOM-02D--3DModel-STEP-56544.STEP]
2019-12-16 with button
    [PTS810SJG250SMTRLFS.stp]
2020-01-14 with st26C31 differential driver symbol
2020-05-08 better footprint
2020-06-06 with tle493 footprint center in sensitive area
2020-06-07 with 3d model
    [TLE493d.step]
2020-06-25 with optical encoder footprint
