Roboy/kicad_db/(notices)

Notices in the files:
_3Dmodels/Capacitors_Radial_THT/CP_Radial_D10.0mm_P3.80mm.step:
Copyright (C) 2017, kicad StepUp
This program is free software: you can redistribute it and/or modify
it under the terms of the GNU General Public License as published by
the Free Software Foundation, either version 3 of the License, or
any later version.
itself might be covered by the GNU General Public License.
_3Dmodels/4UCON_17809/4UCON_17809_02x10x1.27mm_Vertical.step:
Copyright (C) 2017, Ray Benitez
